Phil-dav/OpenAstroTracker/OpenAstroTracker/Pieces STL/images/Veil_500mm_dunkler.jpg

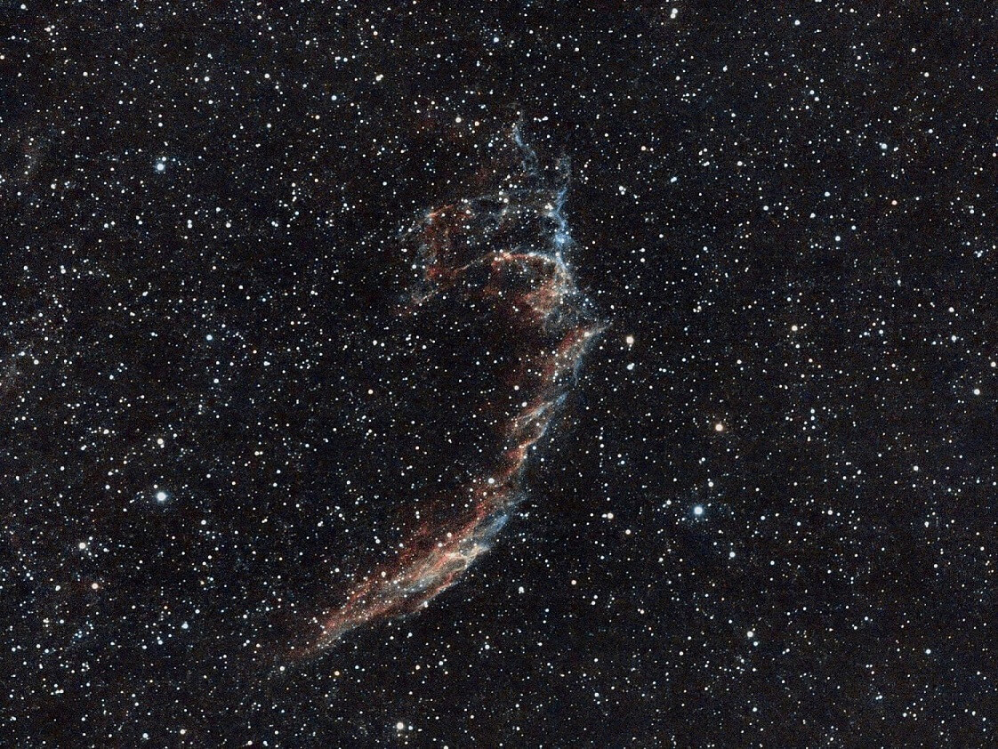
OpenAstroTracker/Pieces STL/images/Veil_500mm_dunkler.jpg
