Phil-dav/OpenAstroTracker/OpenAstroTracker/Pieces STL/images/11_DEC_motor_mount_v6.png

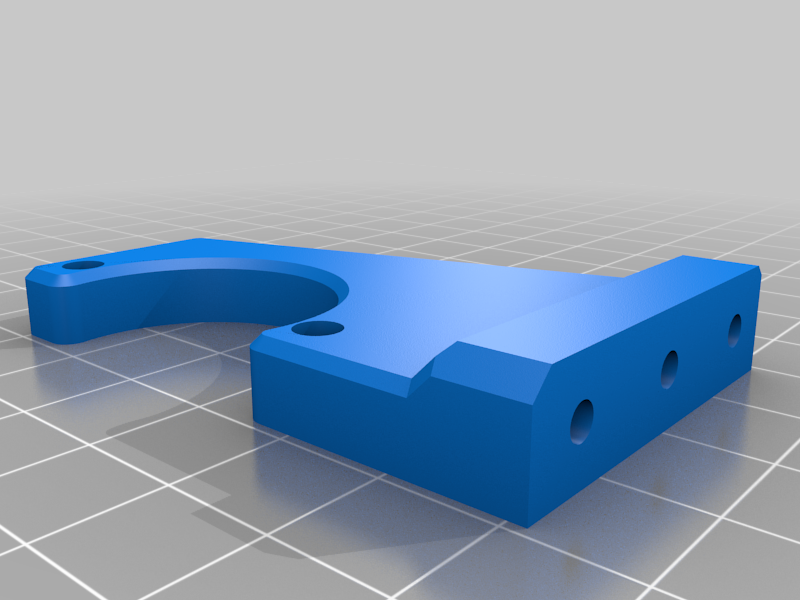
OpenAstroTracker/Pieces STL/images/11_DEC_motor_mount_v6.png
