Phil-dav/OpenAstroTracker/OpenAstroTracker/Pieces STL/README.txt

OpenAstroTracker - DSLR tracking & GoTo mount by openastrotech on Thingiverse: https://www.thingiverse.com/thing:4167783
