Phil-dav/OpenAstroTracker/OpenAstroTracker/Pieces STL/images/05.1_pole_v4.png

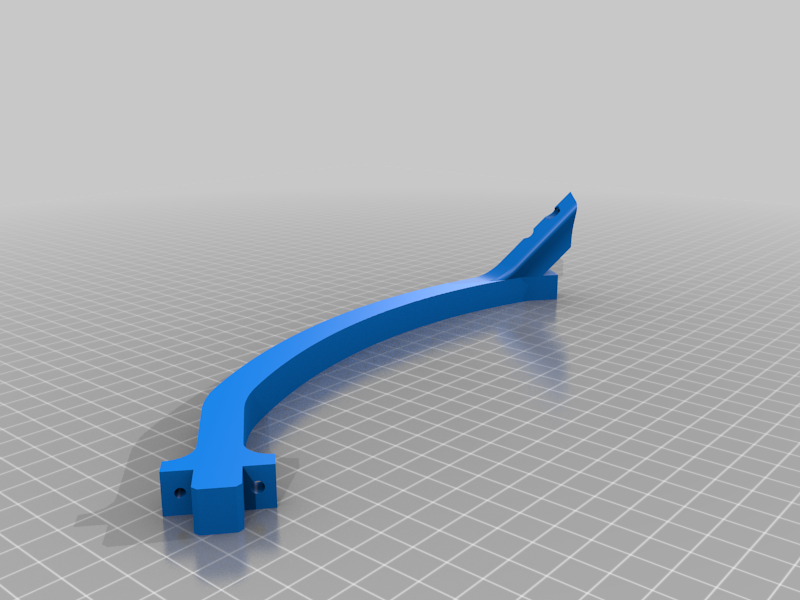
OpenAstroTracker/Pieces STL/images/05.1_pole_v4.png
