Phil-dav/OpenAstroTracker/OpenAstroTracker/Pieces STL/images/05_pole_v5.png

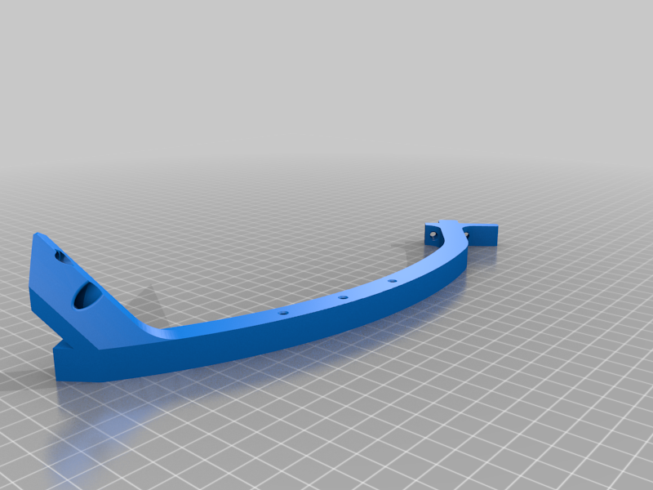
OpenAstroTracker/Pieces STL/images/05_pole_v5.png
