Phil-dav/OpenAstroTracker/OpenAstroTracker/Pieces STL/images/06a_splitring_part1_timingbelt.png

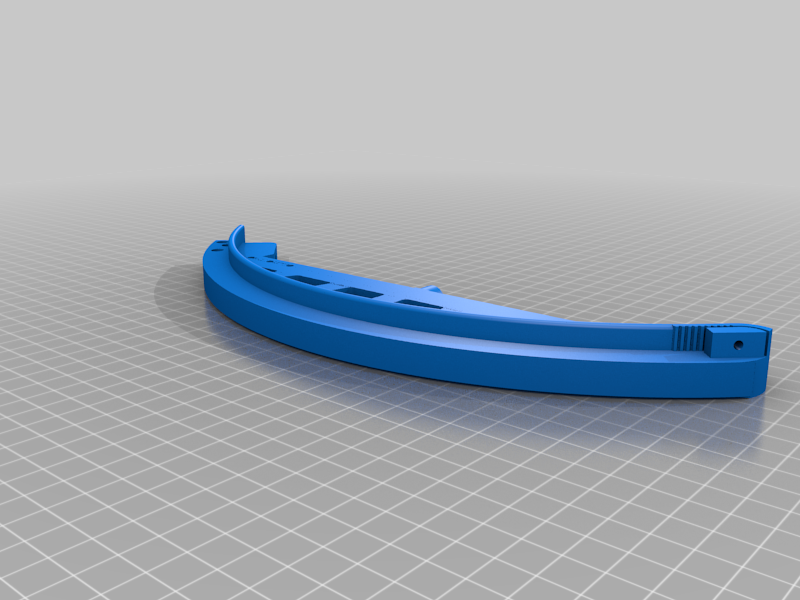
OpenAstroTracker/Pieces STL/images/06a_splitring_part1_timingbelt.png
