Phil-dav/OpenAstroTracker/OpenAstroTracker/Pieces STL/images/06b_splitring_part2_timingbelt.png

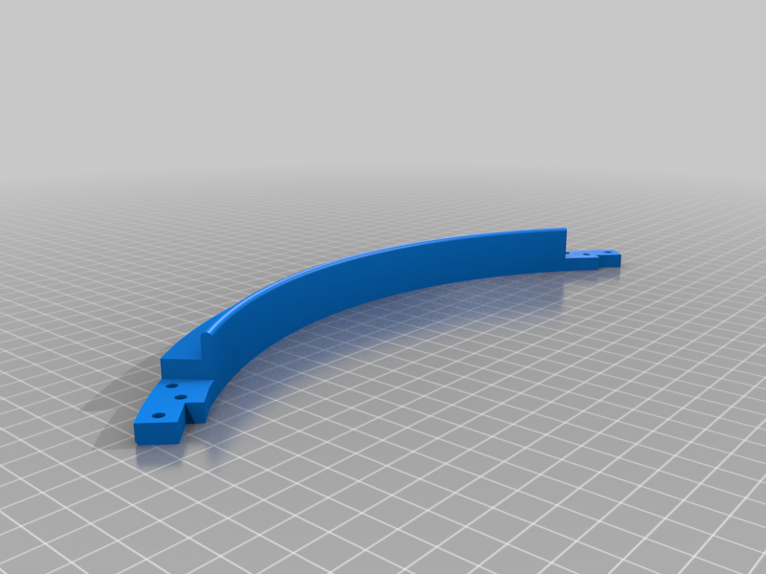
OpenAstroTracker/Pieces STL/images/06b_splitring_part2_timingbelt.png
