Phil-dav/OpenAstroTracker/OpenAstroTracker/Pieces STL/images/06b_splitring_part2_v4.png

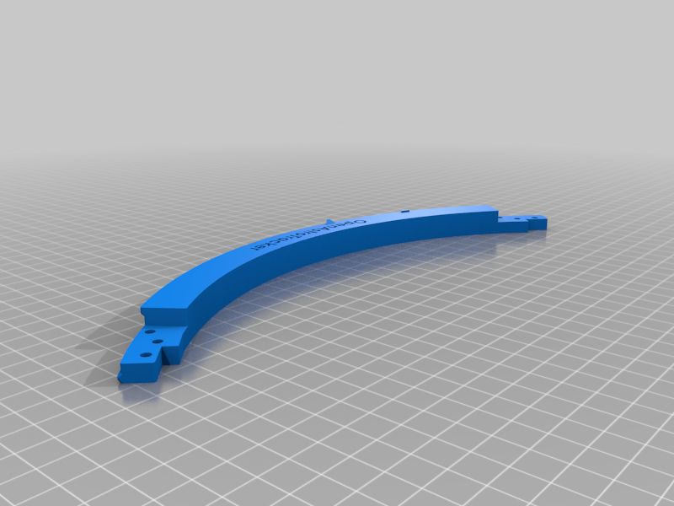
OpenAstroTracker/Pieces STL/images/06b_splitring_part2_v4.png
