Phil-dav/OpenAstroTracker/OpenAstroTracker/Pieces STL/images/06c_splitring_part3_v4.png

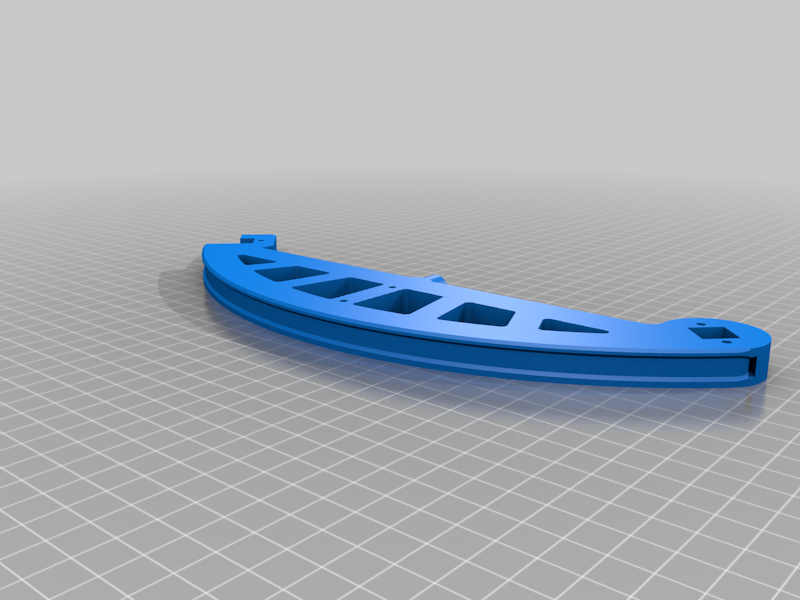
OpenAstroTracker/Pieces STL/images/06c_splitring_part3_v4.png
