Phil-dav/OpenAstroTracker/OpenAstroTracker/Pieces STL/images/11_DEC_motor_mount_v8_low.png

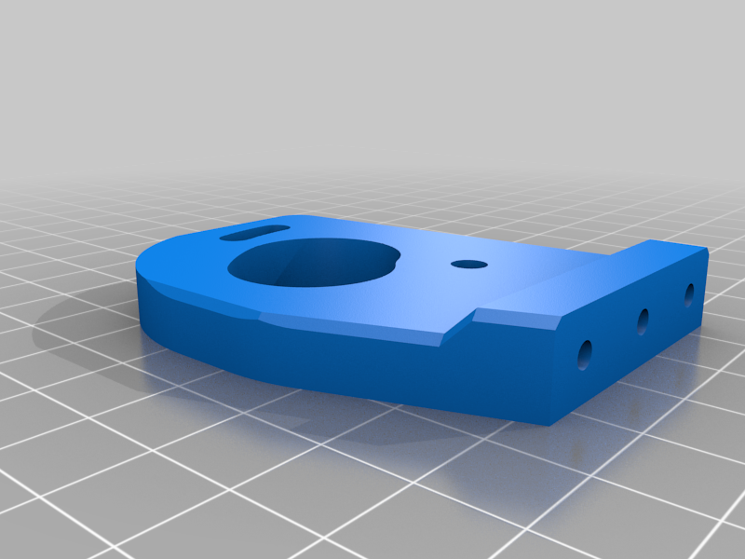
OpenAstroTracker/Pieces STL/images/11_DEC_motor_mount_v8_low.png
