Phil-dav/OpenAstroTracker/OpenAstroTracker/Pieces STL/images/14_RAmotor_mount_low_v4.png

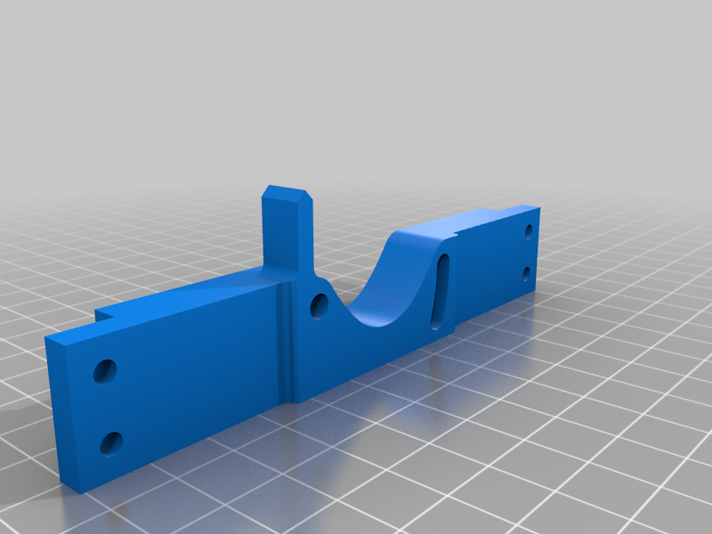
OpenAstroTracker/Pieces STL/images/14_RAmotor_mount_low_v4.png
