Phil-dav/OpenAstroTracker/OpenAstroTracker/Pieces STL/images/14_RAmotor_mount_NEMA_down_v4.png

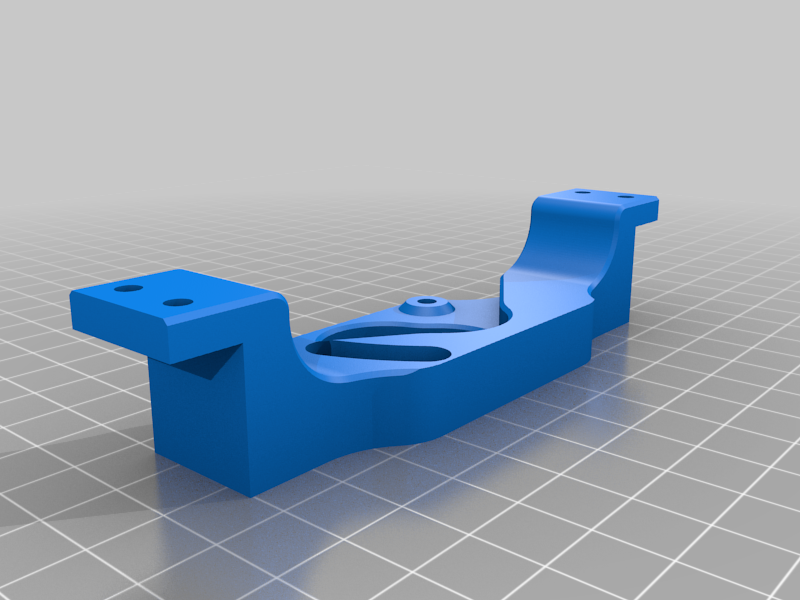
OpenAstroTracker/Pieces STL/images/14_RAmotor_mount_NEMA_down_v4.png
