Phil-dav/OpenAstroTracker/OpenAstroTracker/Pieces STL/images/Cygnus_Wall.jpg

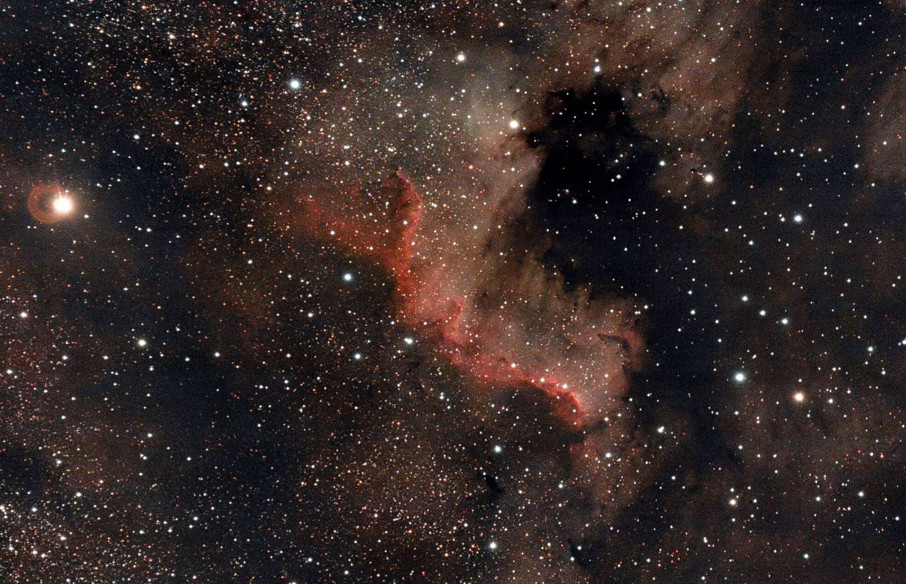
OpenAstroTracker/Pieces STL/images/Cygnus_Wall.jpg
