Phil-dav/OpenAstroTracker/OpenAstroTracker/Pieces STL/images/DSC02870_-_1.JPG

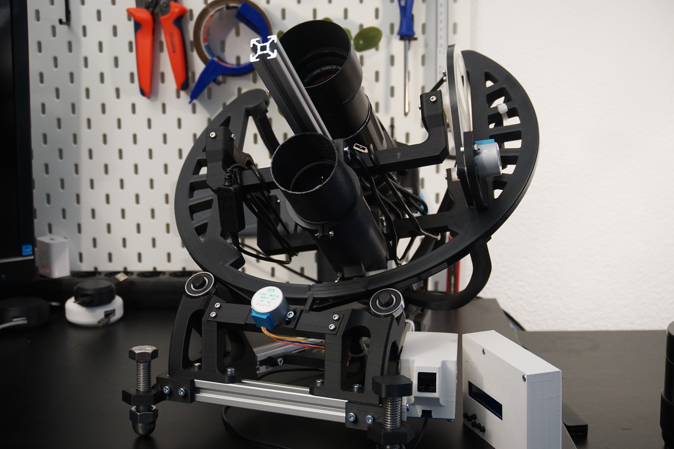
OpenAstroTracker/Pieces STL/images/DSC02870_-_1.JPG
