Phil-dav/OpenAstroTracker/OpenAstroTracker/Pieces STL/images/Rosette_200mm.jpg

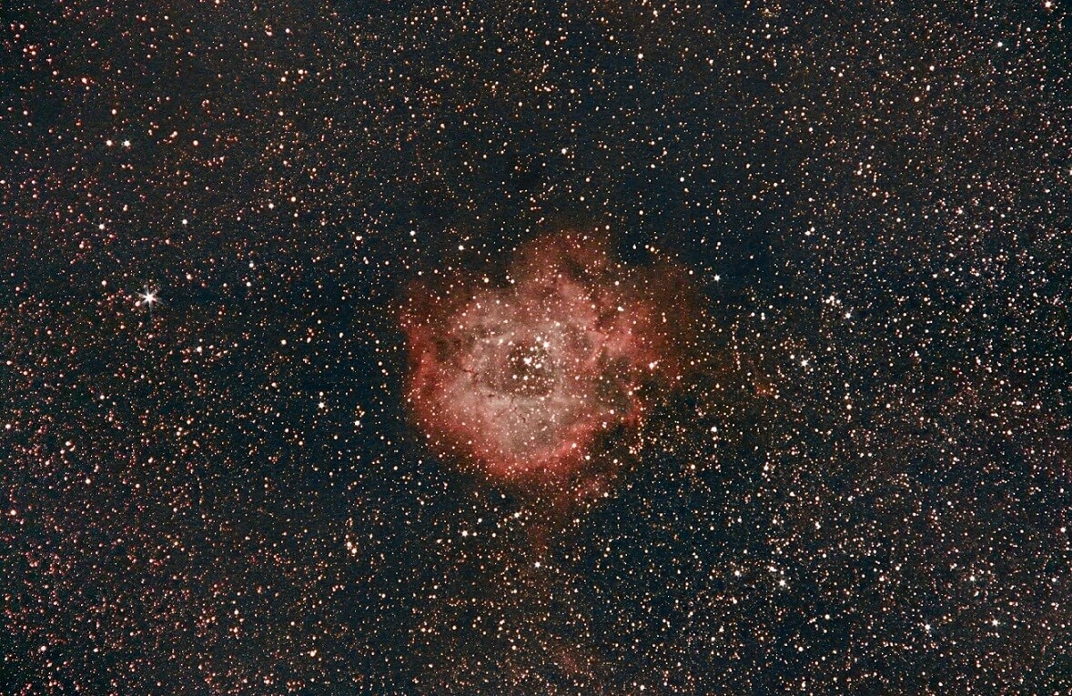
OpenAstroTracker/Pieces STL/images/Rosette_200mm.jpg
