Phil-dav/OpenAstroTracker/OpenAstroTracker/Pieces STL/images/Sadr_mosaic.jpg

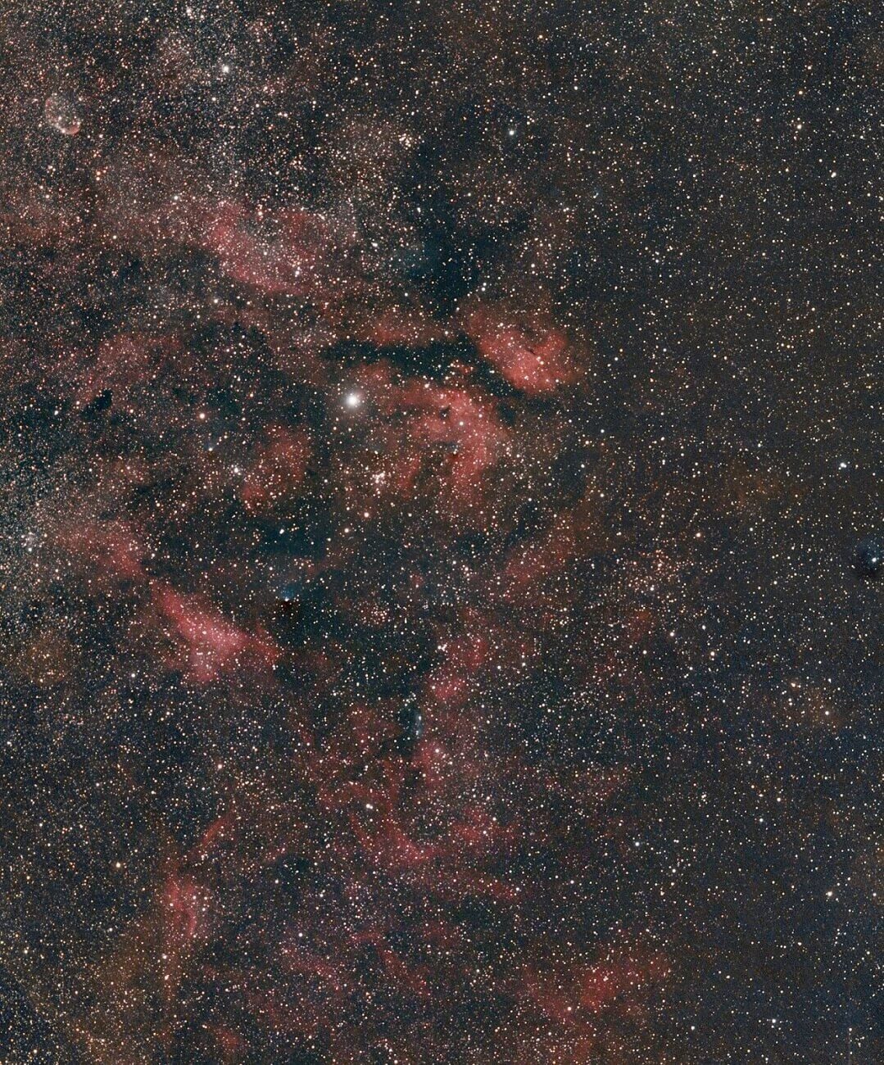
OpenAstroTracker/Pieces STL/images/Sadr_mosaic.jpg
