Phil-dav/OpenAstroTracker/OpenAstroTracker/Pieces STL/images/Veil_Nebula.jpg

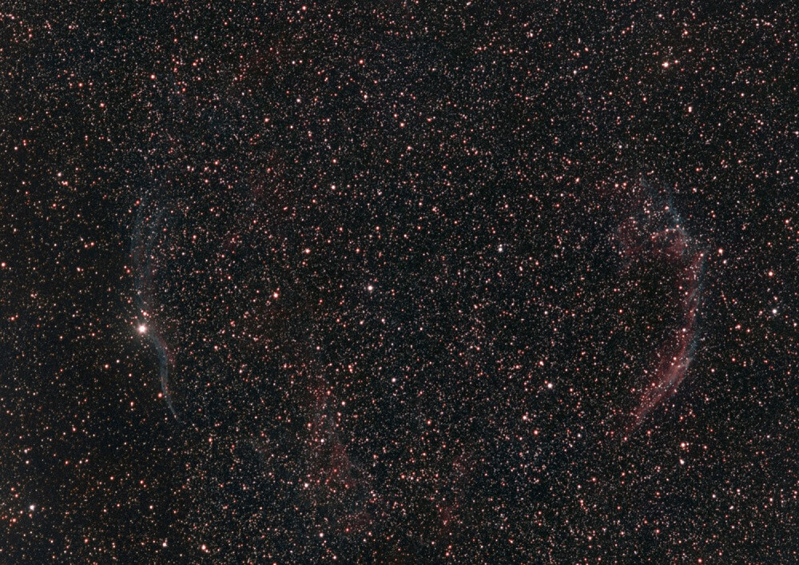
OpenAstroTracker/Pieces STL/images/Veil_Nebula.jpg
