Phil-dav/OpenAstroTracker/OpenAstroTracker/OpenAstroTracker.ods

Sheet: Matériel
Site web vidéo (https://www.youtube.com/watch?v=-_auhM7WlDY&t=2187s)
Matériel ma liste achat
Contrôleur | Arduino MEGA | Aliexpress (https://fr.aliexpress.com/item/32850843888.html?mp=1)
Driver moteur | TMC2209 V4 | Aliexpress (https://fr.aliexpress.com/item/1005004604384978.html?mp=1) | Github (https://github.com/janelia-arduino/TMC2209)
Bouclier Arduino mega | RAMPS 1.4 | Aliexpress (https://fr.aliexpress.com/item/4001009988191.html?mp=1)
Moteur pas à pas | JK42HM34-1334 | Aliexpress (https://fr.aliexpress.com/item/1005001780042317.html?curPageLogUid=1Xe0u0MpPdUn)
Alimentation | 12V 5A
site OpenAstro Tracker (https://wiki.openastrotech.com/OpenAstroTracker/ShoppingList)
Type | Taille | Qté | Lien | PU | P.TOT
Liste pièces mécanique
Vis | M3 x 12mm | 60 |  |  | 0,00 €
Vis | M4 x 12mm | 40 |  |  | 0,00 €
Écrous | M3 | 10 |  |  | 0,00 €
Écrous | M4 x 12mm | 4 |  |  | 0,00 €
Écrous en T | M4 (qté 32) | 1 | Aliexpress (https://s.click.aliexpress.com/e/_AefrLD) | 4,40 € | 4,40 €
Inserts chauffants | M3 x 4,6 x 6 (qté 60) | 1 | Aliexpress (https://s.click.aliexpress.com/e/_AkxV9W) | 7,04 € | 7,04 €
Roulements à billes | 6001ZZ 2RS 12x28x8 mm | 4 | Aliexpress (https://s.click.aliexpress.com/e/_AtjH6R) | 1,24 € | 4,96 €
Roulements à billes | 6801 2RS 12x21x5 mm | 1 | Aliexpress (https://s.click.aliexpress.com/e/_9HGluj) | 1,20 € | 1,20 €
Courroie | GT2 6mm, Pas : 2mm | 1 | Aliexpress (https://s.click.aliexpress.com/e/_9fPOpt) | 6,06 € | 6,06 €
Poulie | GT2, d=5mm, 16T | 2 | Aliexpress (https://s.click.aliexpress.com/e/_APxEH1) | 1,98 € | 3,95 €
Extrusion d’aluminium 2020 argent | Fentes 300 mm, 20x20, 6mm | 3 | Aliexpress (https://s.click.aliexpress.com/e/_9HfYqF) | 5,45 € | 16,35 €
Extrusion d’aluminium 2020 argent | Fentes 200 mm, 20x20, 6mm | 1 | Aliexpress (https://s.click.aliexpress.com/e/_9HfYqF) | 4,11 € | 4,11 €
plaque à dégagement | QR-120S | 1 | Aliexpress (https://s.click.aliexpress.com/e/_AM3KRV) | 16,65 € | 16,65 €
 |  |  |  | S/Total | 64,72 €
Liste pièces électronique |  |  |  |  | 0,00 €
Driver moteur | TMC2209 V3 UART | 2 | Aliexpress (https://s.click.aliexpress.com/e/_A9hcPV) | 6,06 € | 12,12 €
Bouclier Arduino mega | RAMPS 1.4 | 1 | Aliexpress (https://fr.aliexpress.com/item/32964178488.html?gatewayAdapt=glo2fra) | 3,56 € | 3,56 €
Moteur pas à pas | 42HS34 | 2 | Aliexpress (https://fr.aliexpress.com/item/1005005281739306.html?mp=1) | 2,45 € | 4,90 €
Microcontrôleur | Arduino MEGA | 1 | Aliexpress (https://fr.aliexpress.com/item/32837987554.html?gatewayAdapt=glo2fra) | 11,04 € | 11,04 €
Alimentation | 12V 5A | 0 | Aliexpress (https://de.aliexpress.com/item/4000594896227.html?curPageLogUid=b2LSTh6E30wo) | 10,08 € | 0,00 €
Niveau à bulle | MPU6050 | 0 | Aliexpress (https://fr.aliexpress.com/item/1005001423725674.html?curPageLogUid=iWajDq34SGA2) | 2,71 € | 0,00 €
Écran | Schild LCD1602 | 0 | Aliexpress (https://de.aliexpress.com/item/32346775046.html) | 3,09 € | 0,00 €
GPS | GY-NEO6MV2 | 0 | Aliexpress (https://fr.aliexpress.com/item/1005001635722164.html?gatewayAdapt=glo2fra) | 2,59 € | 0,00 €
Prise CC | prise CC femelle et mâle | 1 | Aliexpress (https://fr.aliexpress.com/item/1005002476509656.html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) | 0,17 € | 0,17 €
 |  |  |  | S/Total | 31,79 €
Liste PLA
Bobine PLA | Noire | 1 | Aliexpress (https://fr.aliexpress.com/item/1005005828733628.html?mp=1) | 21,37 € | 21,37 €
Bobine PLA | Bleu | 1 | Aliexpress (https://fr.aliexpress.com/item/1005005828733628.html?mp=1) | 22,21 € | 22,21 €
 |  |  |  | S/Total | 43,58 €
 |  |  |  | port env | 8,00 €
 |  |  |  | Total | 148,09 €
Manque niveau à bulle

Sheet: Impression 3D
 | 00_calibration.stl (https://wiki.openastrotech.com/Knowledge/Printing)
 | Mesure plan | Mesure Réelle
 | 12 | 11,95
 | 50 | 49,94
 | 50 | 49,82
 |  |  |  |  |  |  |  |  | 22
 | Assemblage OpenAstro Tracker (https://wiki.openastrotech.com/en/OpenAstroTracker/Assembly#Assemblage%20OpenAstro%20Tracker)
 | Pièces SLT |  |  |  |  |  |  |  |  |  |  | 26 Adaptater
 | Liste pièces Github (https://github.com/OpenAstroTech/OpenAstroTracker/tree/master/STL)
 | Liste pièces Google docs (https://docs.google.com/spreadsheets/d/1aTgntsu-4ORosllMIWCY5KyekX660bD8m7at5K0p5JA/edit#gid=0)
 | L'assemblage kit (https://wiki.openastrotech.com/OpenAstroTracker/Kit-Assembly)
 |  |  |  |  |  |  | 23 | 24
 |  | 25 |  | 13 |  |  |  |  |  | 11 |  |  | 15 |  | 7
 |  |  | 12
 |  |  |  |  |  |  |  |  |  |  |  | 18 -19
 | Non utilisé |  | 1 | 2 |  | 3 |  | 4
 |  |  |  |  |  |  |  |  |  | 8 |  |  | 10 |  | 5 | 6
 |  |  | 21
 |  |  |  |  |  |  |  |  |  |  |  |  | 16 -17
 |  |  |  |  | 20
 |  |  |  |  |  |  |  | 14
 |  |  |  |  |  |  |  |  |  |  |  | 9
 |  |  |  |  |  |  |  |  |  |  |  | Base
 |  |  |  |  |  |  |  |  |  |  |  | Anneau
N° | Désignation |  | Pages Github |  |  |  |  |  |  | Dossier | Qté | Ordre montage | Nom fr | Temps IMP | Support
26 | b3_2020adapter |  | https://github.com/OpenAstroTech/OpenAstroTracker/blob/master/STL/2020 Base/b3_2020 adapter.STL |  |  |  |  |  |  | de 2020base | 1 | 1 | Adaptateur | 00:50
23 | b1_connector_left |  | https://github.com/OpenAstroTech/OpenAstroTracker/blob/master/STL/2020 Base/b1_connector_left.STL |  |  |  |  |  |  | de 2020base | 1 | 2,1 | Connecteur de base | 02:00 | oui
24 | b1_connector_right |  | https://github.com/OpenAstroTech/OpenAstroTracker/blob/master/STL/2020 Base/b1_connector_right.STL |  |  |  |  |  |  | de 2020base | 1 | 2,2 | Connecteur de base
12 | M14_mount_left_2020base |  | https://github.com/OpenAstroTech/OpenAstroTracker/blob/master/STL/2020 Base/M14_mount_left_2020base.STL |  |  |  |  |  |  | de 2020base | 1 | 3,1 | montage frontal
13 | M14_mount_right_2020base |  | https://github.com/OpenAstroTech/OpenAstroTracker/blob/master/STL/2020 Base/M14_mount_right_2020base.STL |  |  |  |  |  |  | de 2020base | 1 | 3,2 | montage frontal
25 | b2_level_holder |  | https://github.com/OpenAstroTech/OpenAstroTracker/blob/master/STL/2020 Base/b2_level holder_31mm.STL |  |  |  |  |  |  | de 2020base | 1 | 4 | Porte niveau
3 | 04_rollmount_left_40°_v6_2020base_TI |  | https://github.com/OpenAstroTech/OpenAstroTracker/blob/master/STL/40deg/04_rollmount left_40°_v6_2020base_TI.STL |  |  |  |  |  |  | de 2020base | 1 | 5,1 | Support rouleau | 07:20 | oui
4 | 04_rollmount_right_40°_v6_2020base_TI |  | https://github.com/OpenAstroTech/OpenAstroTracker/blob/master/STL/40deg/04_rollmount right_40°_v6_2020base_TI.STL |  |  |  |  |  |  | de 2020base | 1 | 5,2 | Support rouleau | 07:20 | oui
1 | 02_angle_40deg_v2_2020base |  | https://github.com/OpenAstroTech/OpenAstroTracker/blob/master/STL/40deg/02_angle_40deg_v2_2020base.STL |  |  |  |  |  |  | de 2020base | 1 | 6 | Angle arrière | 03:30
14 | M14_mount_rear_2020base_v2 |  | https://github.com/OpenAstroTech/OpenAstroTracker/blob/master/STL/2020 Base/M14_mount_rear_2020base_v2.STL |  |  |  |  |  |  | de 2020base | 1 | 7 | Support arrière
15 | 14_RAmotor_mount_NEMA_down_v4 |  | https://github.com/OpenAstroTech/OpenAstroTracker/blob/master/STL/All latitudes/14_RAmotor_mount_NEMA_down_v4.STL |  |  |  |  |  |  |  | 1 | 8 | Support moteur RA
11 | 11_DEC_motor_mount_v9_NEMA_TI |  | https://github.com/OpenAstroTech/OpenAstroTracker/blob/master/STL/All latitudes/11_DEC_motor_mount_v9_NEMA_TI.STL |  |  |  |  |  |  |  | 1 | A1 | Support moteur DEC
8 | 06a_splitring_part1_v4_TI |  | https://github.com/OpenAstroTech/OpenAstroTracker/blob/master/STL/All latitudes/06a_splitring_part1_v4_TI.STL |  |  |  |  |  |  |  | 1 | A2 | Anneau RA support moteur DEC | 02:00
9 | 06b_splitring_part2_v4_TI |  | https://github.com/OpenAstroTech/OpenAstroTracker/blob/master/STL/All latitudes/06b_splitring_part2_v4_TI.STL |  |  |  |  |  |  |  | 1 | A2,1 | Anneau centre
20 | u2_bearing_holder_TI |  | https://github.com/OpenAstroTech/OpenAstroTracker/blob/master/STL/Universal mount/u2_bearing_holder_TI.STL |  |  |  |  |  |  | de Universal_mount | 1 | A3,1 | Support roulement DEC
18 | u1_Lholder_right_back |  | https://github.com/OpenAstroTech/OpenAstroTracker/blob/master/STL/Universal mount/u1_Lholder_right_back.STL |  |  |  |  |  |  | de Universal_mount | 1 | A3,2 | Support roulement DEC
19 | u1_Lholder_right_front |  | https://github.com/OpenAstroTech/OpenAstroTracker/blob/master/STL/Universal mount/u1_Lholder_right_front.STL |  |  |  |  |  |  | de Universal_mount | 1 | A3,3 | Support roulement DEC
10 | 06c_splitring_part3_v4_TI |  | https://github.com/OpenAstroTech/OpenAstroTracker/blob/master/STL/All latitudes/06c_splitring_part3_v4_TI.STL |  |  |  |  |  |  |  | 1 | A3,4 | Anneau RA support roue
21 | u3_drivedisc_DEC_unimount_v3_TI |  | https://github.com/OpenAstroTech/OpenAstroTracker/blob/master/STL/Universal mount/u3_drivedisc_DEC_unimount_v3_TI.STL |  |  |  |  |  |  |  | 1 | A4,1 | Roue DEC | 09:00
16 | u1_Lholder_left_back |  | https://github.com/OpenAstroTech/OpenAstroTracker/blob/master/STL/Universal mount/u1_Lholder_left_back.STL |  |  |  |  |  |  | de Universal_mount | 1 | A4,2 | Support roue
17 | u1_Lholder_left_front |  | https://github.com/OpenAstroTech/OpenAstroTracker/blob/master/STL/Universal mount/u1_Lholder_left_front.STL |  |  |  |  |  |  | de Universal_mount | 1 | A4,3 | Support roue
2 | 03_polemount_6801_v3_TI |  | https://github.com/OpenAstroTech/OpenAstroTracker/blob/master/STL/All latitudes/03_polemount_6801_v3_TI.STL |  |  |  |  |  |  |  | 1 | A5,1 | Montage sur poteau | 01:30 | oui
5 | 05_pole_v5_TI |  | https://github.com/OpenAstroTech/OpenAstroTracker/blob/master/STL/All latitudes/05_pole_v5_TI.STL |  |  |  |  |  |  |  | 2 | A5,2 | Poteau supérieur | 04:10 | oui
6 | 05.1_pole_v4_TI |  | https://github.com/OpenAstroTech/OpenAstroTracker/blob/master/STL/All latitudes/05.1_pole_v4_TI.STL |  |  |  |  |  |  |  | 2 | A5,3 | Poteau inférieur | 03:50 | oui
7 | 05.2_stabilizer |  | https://github.com/OpenAstroTech/OpenAstroTracker/blob/master/STL/All latitudes/05.2_stabilizer.STL |  |  |  |  |  |  |  | 1 | A5,4 | Stabilisateur | 03:50 | oui
22 | u4_holder |  | https://github.com/OpenAstroTech/OpenAstroTracker/blob/master/STL/Universal mount/u4_holder.STL |  |  |  |  |  |  |  | 2 | A6 | Porteur support camera
 |  |  |  |  |  |  |  |  |  | Total | 29 |  |  | 21:20
 |  |  |  |  |  |  |  |  |  |  |  |  |  | Ender 3 PRO réglage général
 | Attention imp 200X200 |  |  |  |  |  |  |  |  |  |  |  |  | Parois | 3
8 | 06a_splitring_part1_v4_200x200 For_200x200_printers |  |  |  |  |  |  |  |  |  |  |  |  | Couches sup/inf | 4
10 | 06c_splitring_part3_v4_200x200 For_200x200_printers |  |  |  |  |  |  |  |  |  |  |  |  | Remplissage | 20,00 %
 |  |  |  |  |  |  |  |  |  |  |  |  |  | Hauteur de couche | 0,2 | mm
 |  |  |  |  |  |  |  |  |  |  |  |  |  | Buse
 |  |  |  |  |  |  |  |  |  |  |  |  |  | Vitesse | 50 | mm/s
