Phil-dav/OpenAstroTracker/OpenAstroTracker/Pieces STL/06a_splitring_part1_v4f_200x200.STL

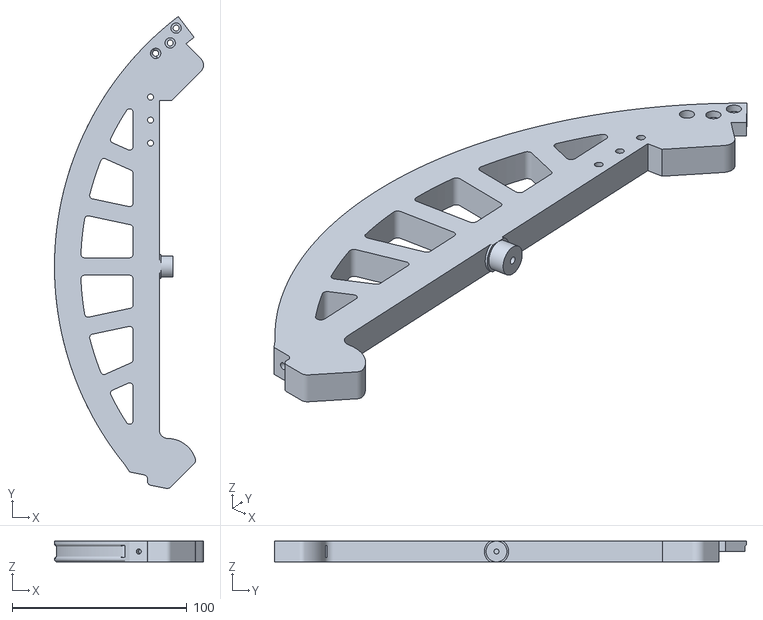
[picture p35: CAD file, 2023-11-13]
OpenAstroTracker/Pieces STL/06a_splitring_part1_v4f_200x200.STL
85.4 x 270.3 x 12.0
