Phil-dav/OpenAstroTracker/OpenAstroTracker/Pieces STL/files/16_NEMA_electronicsbox_lid.STL

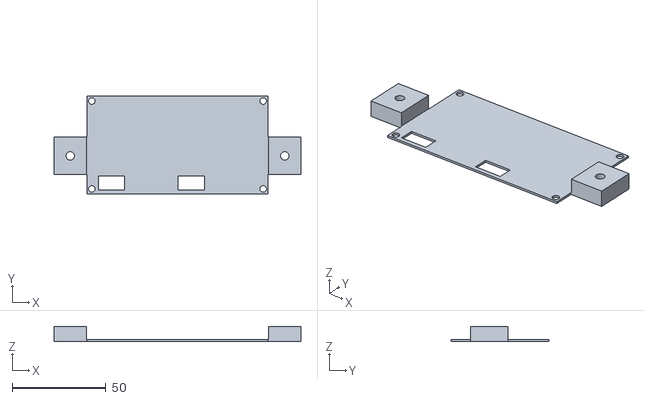
[picture p36: CAD file, 2023-11-13]
OpenAstroTracker/Pieces STL/files/16_NEMA_electronicsbox_lid.STL
132.1 x 52.4 x 8.00
