Phil-dav/OpenAstroTracker/OpenAstroTracker/Pieces STL/files/20deg/04_rollmount left_20°_v5_2020base.STL

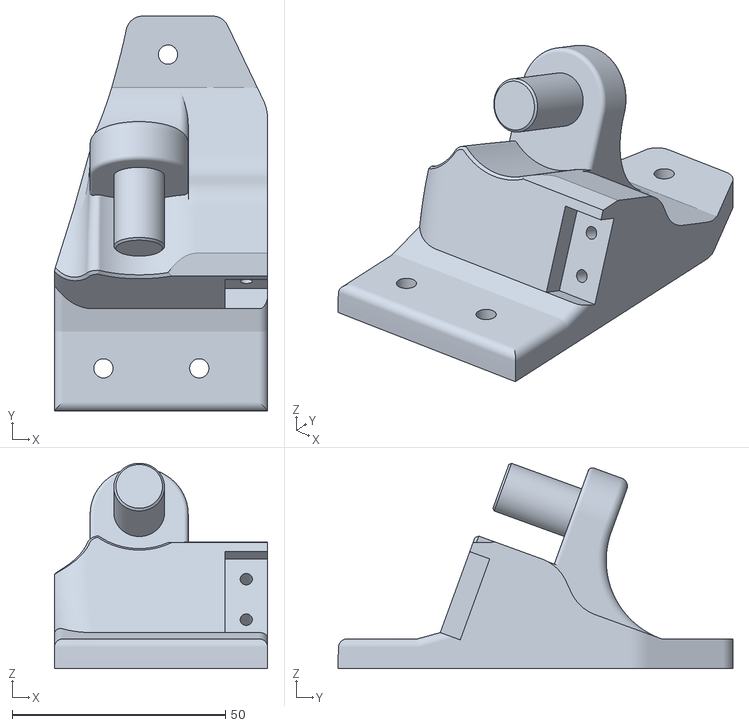
[picture p37: CAD file, 2023-11-13]
OpenAstroTracker/Pieces STL/files/20deg/04_rollmount left_20°_v5_2020base.STL
50.0 x 92.6 x 48.2
