Phil-dav/OpenAstroTracker/OpenAstroTracker/Pieces STL/files/30deg/04_rollmount right_30°_v6_2020base.STL

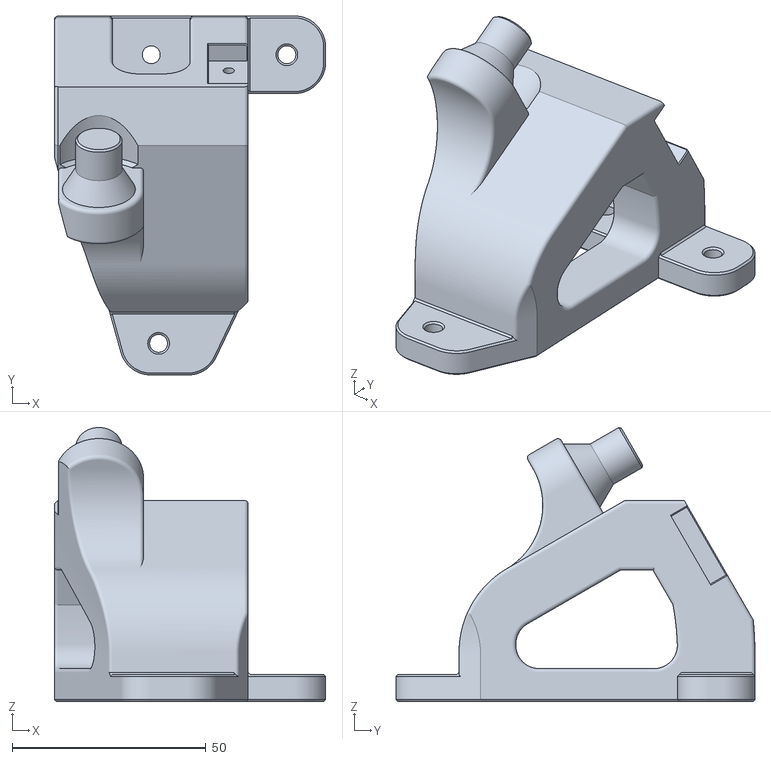
[picture p38: CAD file, 2023-11-13]
OpenAstroTracker/Pieces STL/files/30deg/04_rollmount right_30°_v6_2020base.STL
70.0 x 92.6 x 70.7
