Phil-dav/OpenAstroTracker/OpenAstroTracker/Pieces STL/files/40deg/04_rollmount left_40°_v6_2020base.STL

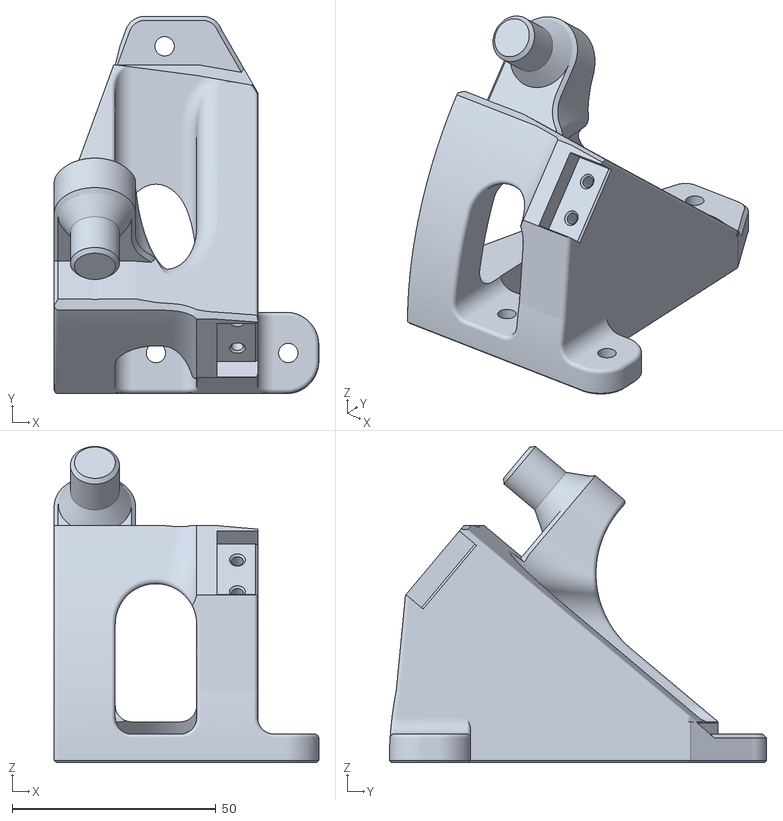
[picture p39: CAD file, 2023-11-13]
OpenAstroTracker/Pieces STL/files/40deg/04_rollmount left_40°_v6_2020base.STL
65.0 x 92.7 x 77.6
