Phil-dav/OpenAstroTracker/OpenAstroTracker/Pieces STL/files/50deg/02_angle_50deg_v4_2020base.STL

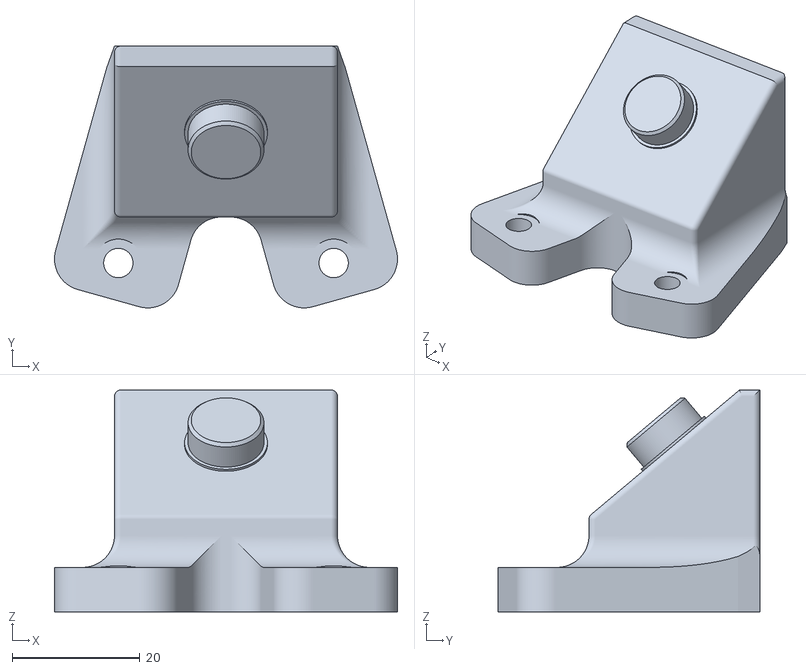
[picture p40: CAD file, 2023-11-13]
OpenAstroTracker/Pieces STL/files/50deg/02_angle_50deg_v4_2020base.STL
53.8 x 41.1 x 34.8
