Phil-dav/OpenAstroTracker/OpenAstroTracker/Pieces STL/Pièces réalisées/00_calibration.STL

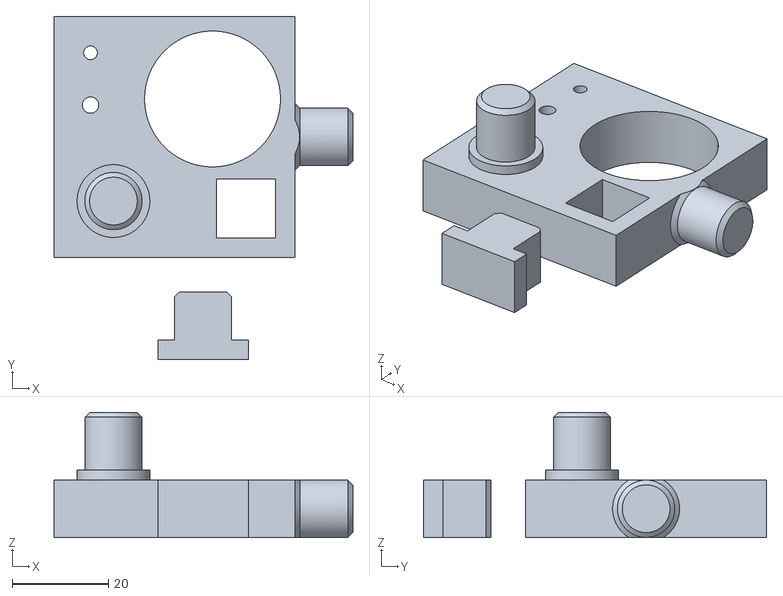
[picture p41: CAD file, 2023-11-13]
OpenAstroTracker/Pieces STL/Pièces réalisées/00_calibration.STL
62.0 x 71.2 x 26.0
