Phil-dav/OpenAstroTracker/OpenAstroTracker/Pieces STL/Pièces à réalisées/M14_mount_rear_2020base_v2.STL

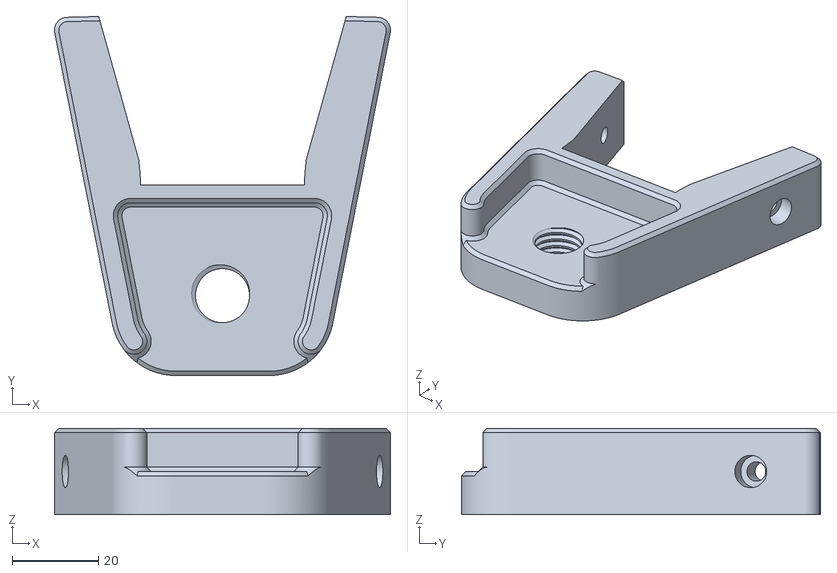
[picture p42: CAD file, 2023-11-13]
OpenAstroTracker/Pieces STL/Pièces à réalisées/M14_mount_rear_2020base_v2.STL
77.8 x 83.2 x 20.0
