Phil-dav/OpenAstroTracker/OpenAstroTracker/Pieces STL/files/06b_splitring_part2_v4.STL

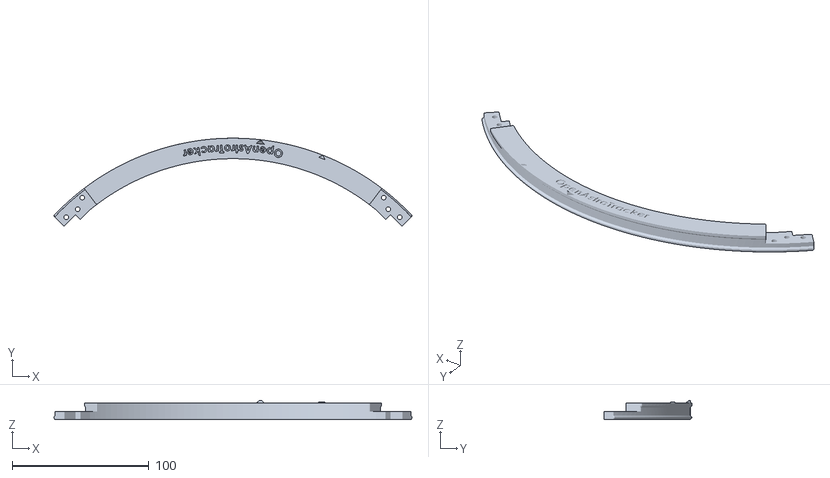
[picture p44: CAD file, 2023-11-13]
OpenAstroTracker/Pieces STL/files/06b_splitring_part2_v4.STL
262.1 x 64.2 x 14.0
