Phil-dav/OpenAstroTracker/OpenAstroTracker/Pieces STL/files/20deg/02_angle_20deg_2020base.STL

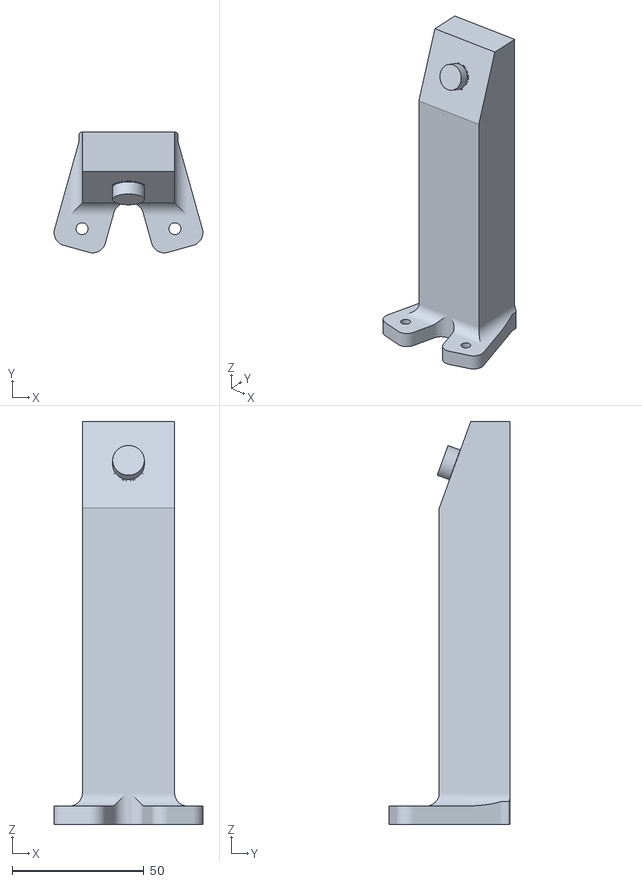
[picture p45: CAD file, 2023-11-13]
OpenAstroTracker/Pieces STL/files/20deg/02_angle_20deg_2020base.STL
56.5 x 45.8 x 152.9
