Phil-dav/OpenAstroTracker/OpenAstroTracker/Pieces STL/Pièces à réalisées/05_pole_v5_TI.STL

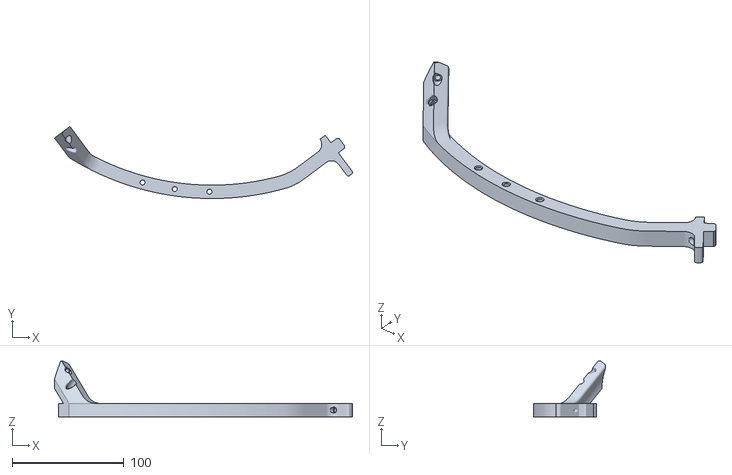
[picture p46: CAD file, 2023-11-13]
OpenAstroTracker/Pieces STL/Pièces à réalisées/05_pole_v5_TI.STL
266.7 x 64.5 x 49.7
