Phil-dav/OpenAstroTracker/OpenAstroTracker/Pieces STL/files/30deg/02_angle_30deg_2020base_v2.STL

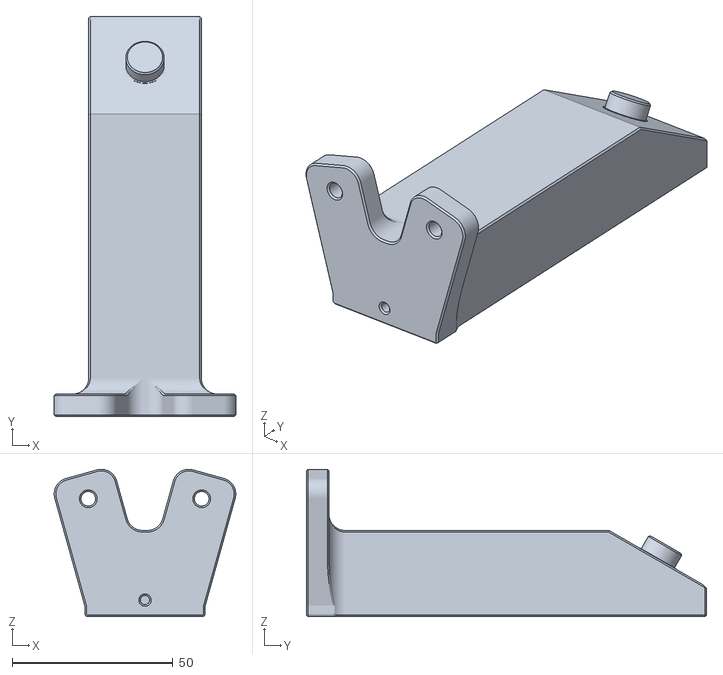
[picture p47: CAD file, 2023-11-13]
OpenAstroTracker/Pieces STL/files/30deg/02_angle_30deg_2020base_v2.STL
56.5 x 124.3 x 45.8
