Phil-dav/OpenAstroTracker/OpenAstroTracker/Pieces STL/files/c1_bottom.STL

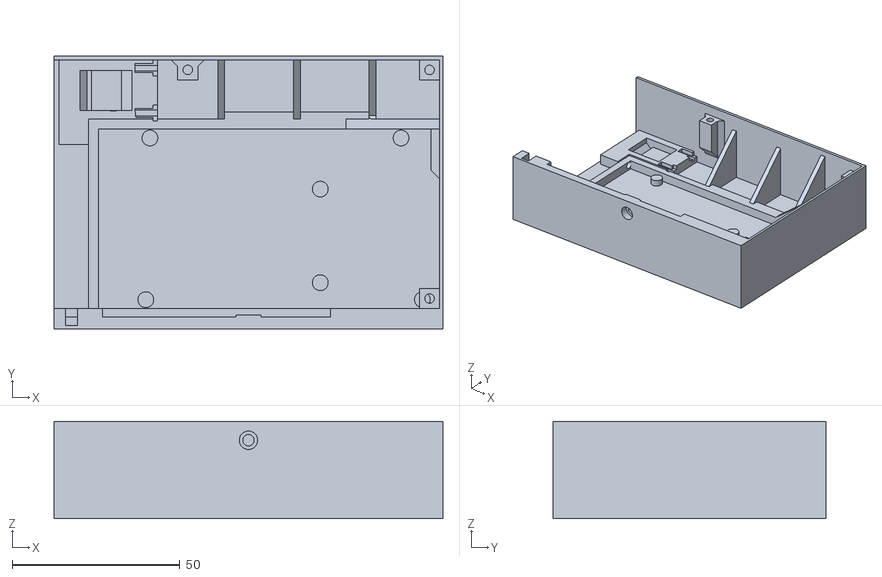
[picture p48: CAD file, 2023-11-13]
OpenAstroTracker/Pieces STL/files/c1_bottom.STL
116.0 x 81.4 x 29.0
