Phil-dav/OpenAstroTracker/OpenAstroTracker/Pieces STL/Pièces à réalisées/11_DEC_motor_mount_v9_NEMA_TI.STL

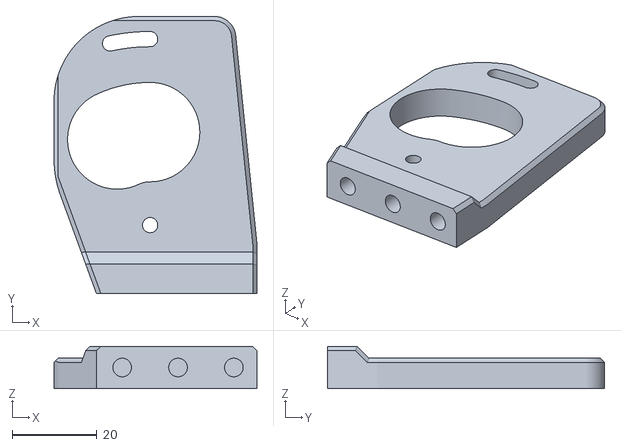
[picture p49: CAD file, 2023-11-13]
OpenAstroTracker/Pieces STL/Pièces à réalisées/11_DEC_motor_mount_v9_NEMA_TI.STL
47.9 x 65.4 x 10.0
