Phil-dav/OpenAstroTracker/OpenAstroTracker/Pieces STL/files/b2_level holder.STL

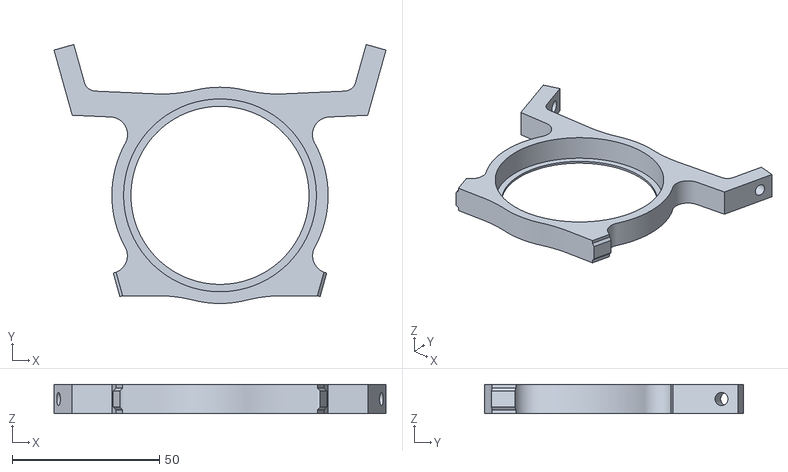
[picture p50: CAD file, 2023-11-13]
OpenAstroTracker/Pieces STL/files/b2_level holder.STL
112.8 x 88.0 x 10.00
