Phil-dav/OpenAstroTracker/OpenAstroTracker/Pieces STL/Pièces à réalisées/02_angle_40deg_v2_2020base.STL

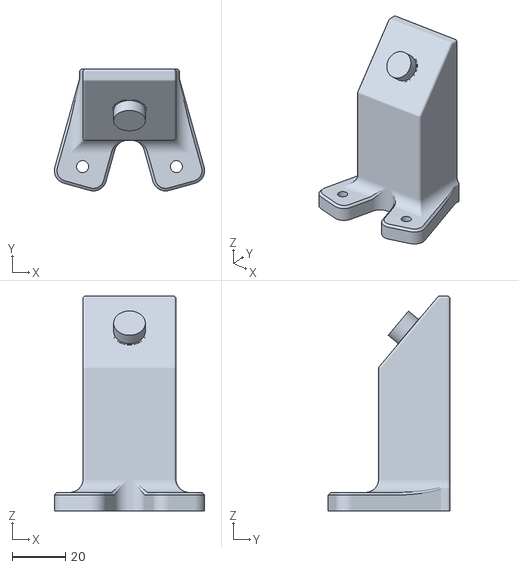
[picture p51: CAD file, 2023-11-13]
OpenAstroTracker/Pieces STL/Pièces à réalisées/02_angle_40deg_v2_2020base.STL
56.5 x 45.8 x 80.8
