Phil-dav/OpenAstroTracker/OpenAstroTracker/Pieces STL/files/b1_connector_right.STL

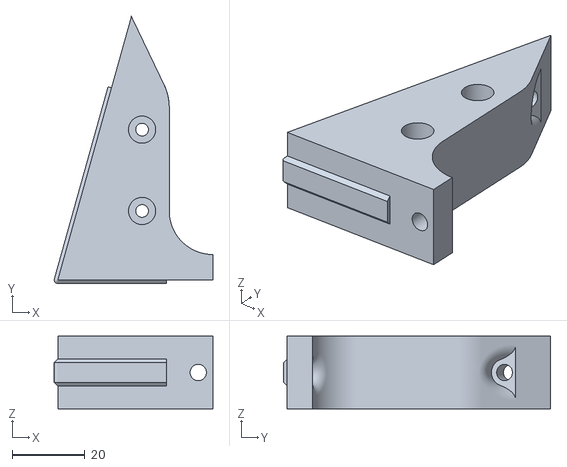
[picture p52: CAD file, 2023-11-13]
OpenAstroTracker/Pieces STL/files/b1_connector_right.STL
43.7 x 73.6 x 20.0
