Phil-dav/OpenAstroTracker/OpenAstroTracker/Pieces STL/files/06a_splitring_part1_v4.STL

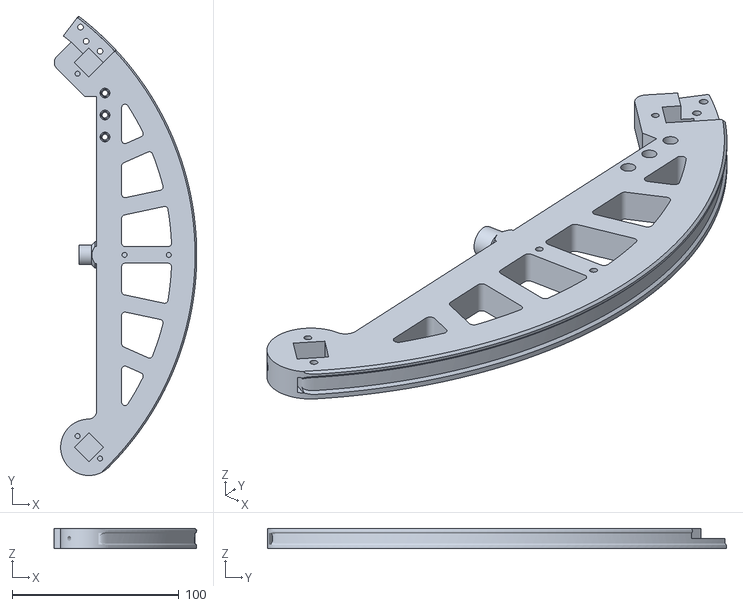
[picture p53: CAD file, 2023-11-13]
OpenAstroTracker/Pieces STL/files/06a_splitring_part1_v4.STL
85.4 x 275.1 x 12.0
