Phil-dav/OpenAstroTracker/OpenAstroTracker/Pieces STL/Pièces à réalisées/03_polemount_6801_v3_TI.STL

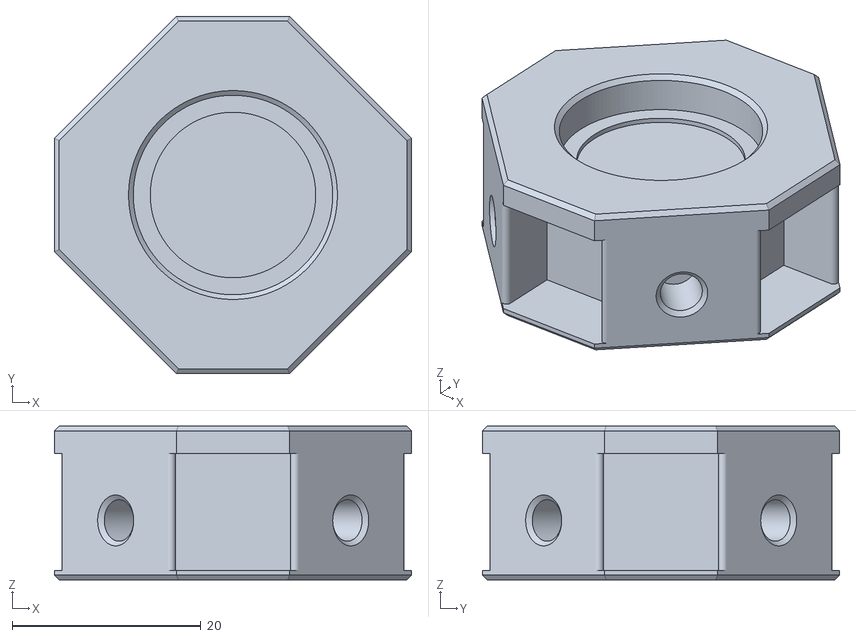
[picture p54: CAD file, 2023-11-13]
OpenAstroTracker/Pieces STL/Pièces à réalisées/03_polemount_6801_v3_TI.STL
37.9 x 37.9 x 16.3
