Phil-dav/OpenAstroTracker/OpenAstroTracker/Pieces STL/files/14_RAmotor_mount_NEMA_down_v4.STL

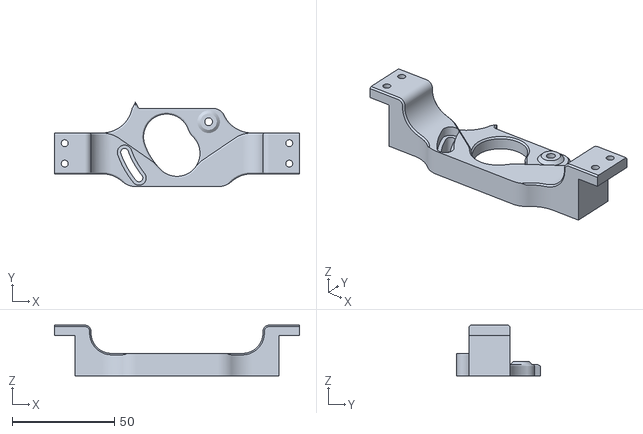
[picture p55: CAD file, 2023-11-13]
OpenAstroTracker/Pieces STL/files/14_RAmotor_mount_NEMA_down_v4.STL
120.0 x 41.3 x 24.8
