Phil-dav/OpenAstroTracker/OpenAstroTracker/Pieces STL/Pièces à réalisées/05.1_pole_v4_TI.STL

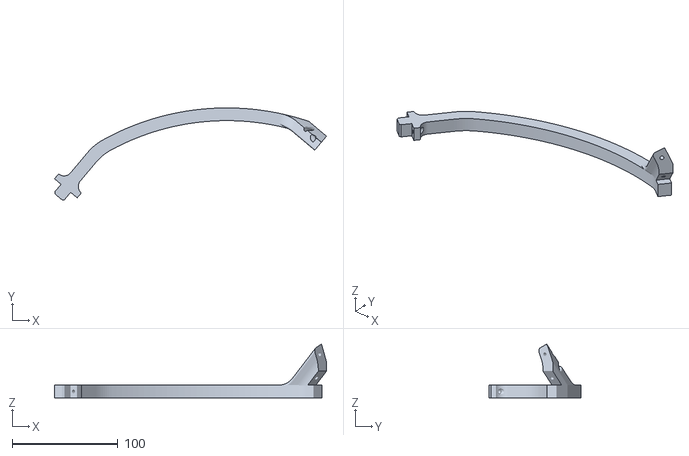
[picture p56: CAD file, 2023-11-13]
OpenAstroTracker/Pieces STL/Pièces à réalisées/05.1_pole_v4_TI.STL
256.6 x 86.9 x 50.7
