Phil-dav/OpenAstroTracker/OpenAstroTracker/Pieces STL/files/c4_buttons.STL

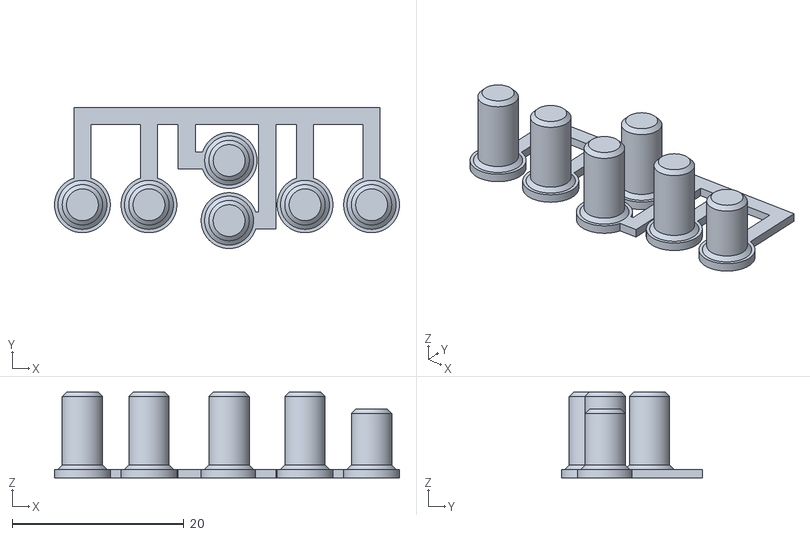
[picture p57: CAD file, 2023-11-13]
OpenAstroTracker/Pieces STL/files/c4_buttons.STL
40.2 x 16.4 x 10.0
