Phil-dav/OpenAstroTracker/OpenAstroTracker/Pieces STL/files/16_NEMA_electronicsbox.STL

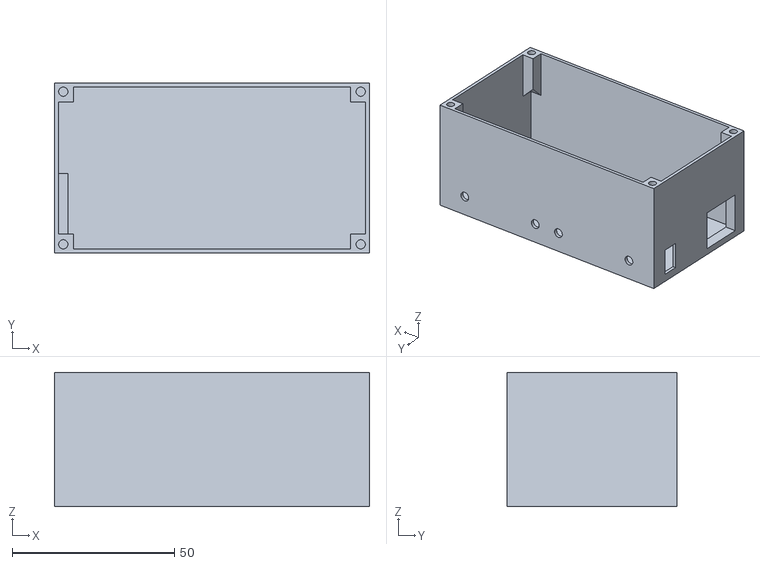
[picture p58: CAD file, 2023-11-13]
OpenAstroTracker/Pieces STL/files/16_NEMA_electronicsbox.STL
97.0 x 52.4 x 41.3
