Phil-dav/OpenAstroTracker/OpenAstroTracker/Pieces STL/Pièces à réalisées/u1_Lholder_right_back.STL

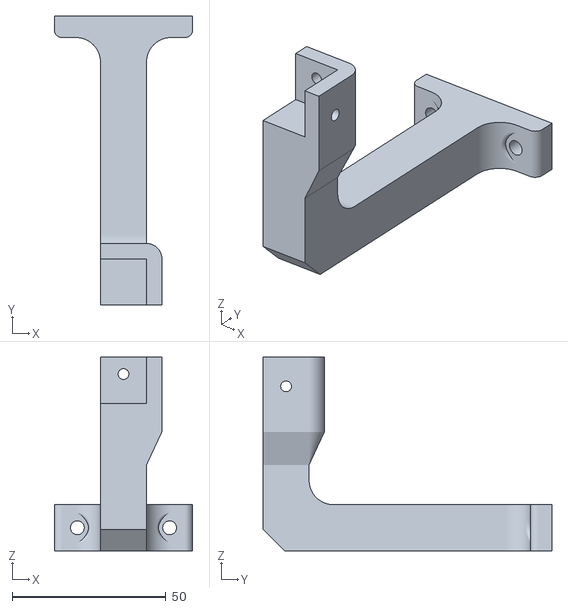
[picture p59: CAD file, 2023-11-13]
OpenAstroTracker/Pieces STL/Pièces à réalisées/u1_Lholder_right_back.STL
45.0 x 94.0 x 63.0
