Phil-dav/OpenAstroTracker/OpenAstroTracker/Pieces STL/files/11_DEC_motor_mount_v7.STL

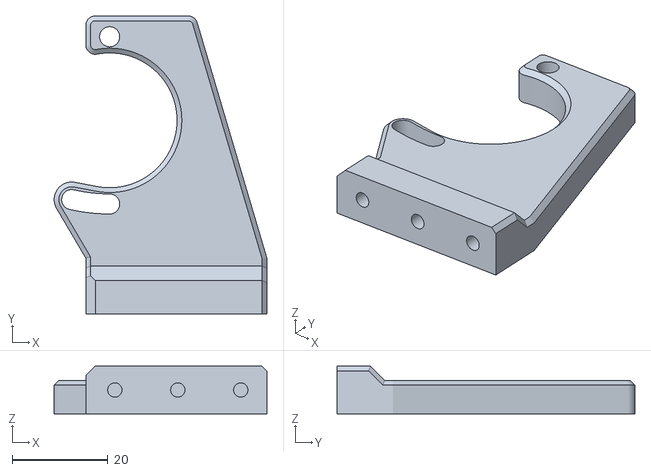
[picture p60: CAD file, 2023-11-13]
OpenAstroTracker/Pieces STL/files/11_DEC_motor_mount_v7.STL
44.5 x 62.4 x 10.0
