Phil-dav/OpenAstroTracker/OpenAstroTracker/Pieces STL/files/01b_Baseplate_part2_universal_200x200_v2.STL

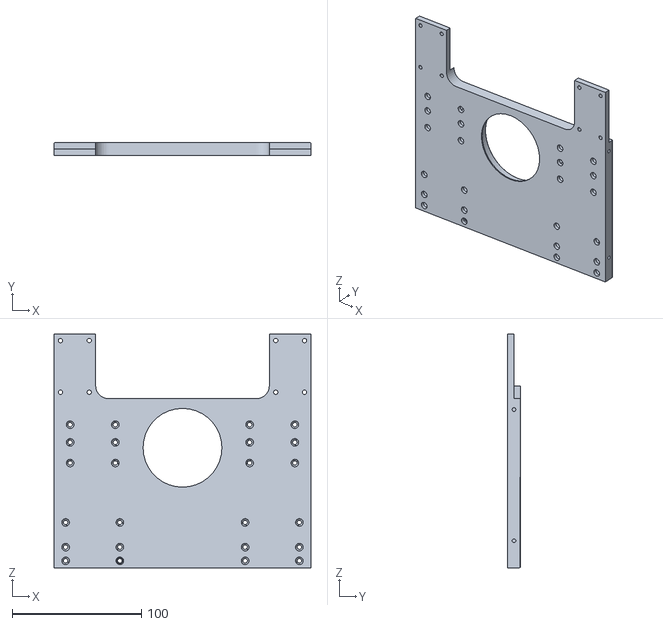
[picture p61: CAD file, 2023-11-13]
OpenAstroTracker/Pieces STL/files/01b_Baseplate_part2_universal_200x200_v2.STL
199.0 x 10.0 x 181.0
