Phil-dav/OpenAstroTracker/OpenAstroTracker/Pieces STL/Pièces à réalisées/b2_level holder_31mm.STL

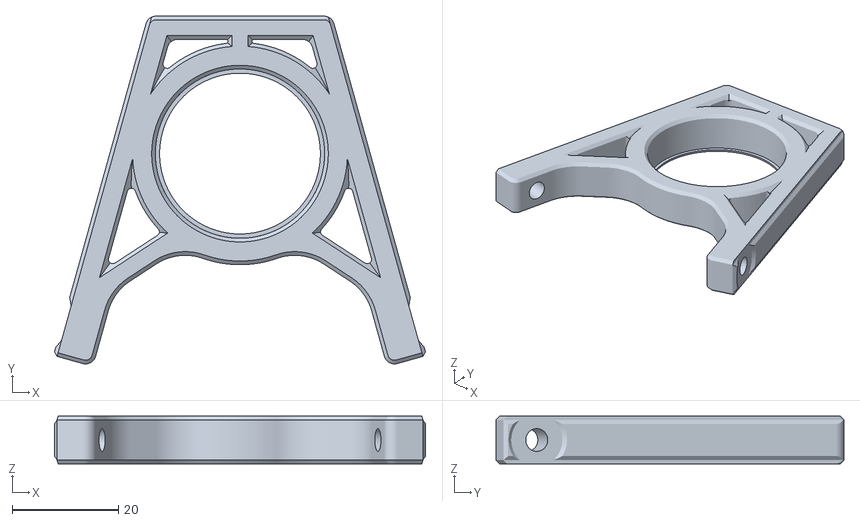
[picture p62: CAD file, 2023-11-13]
OpenAstroTracker/Pieces STL/Pièces à réalisées/b2_level holder_31mm.STL
69.9 x 65.6 x 9.00
