Phil-dav/OpenAstroTracker/OpenAstroTracker/Pieces STL/files/c2_front.STL

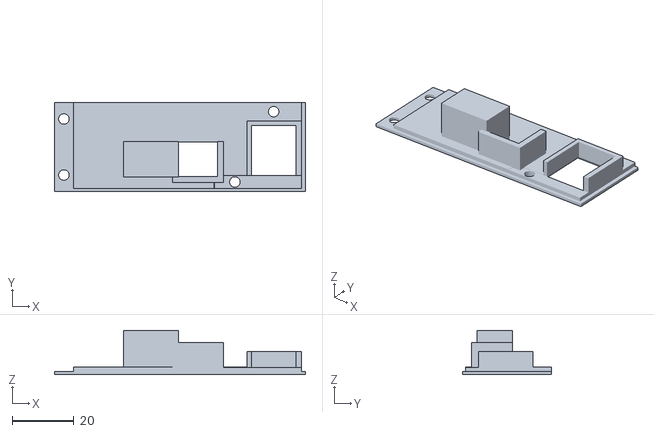
[picture p63: CAD file, 2023-11-13]
OpenAstroTracker/Pieces STL/files/c2_front.STL
81.4 x 29.0 x 14.3
