Phil-dav/OpenAstroTracker/OpenAstroTracker/Pieces STL/Pièces à réalisées/M14_mount_right_2020base.STL

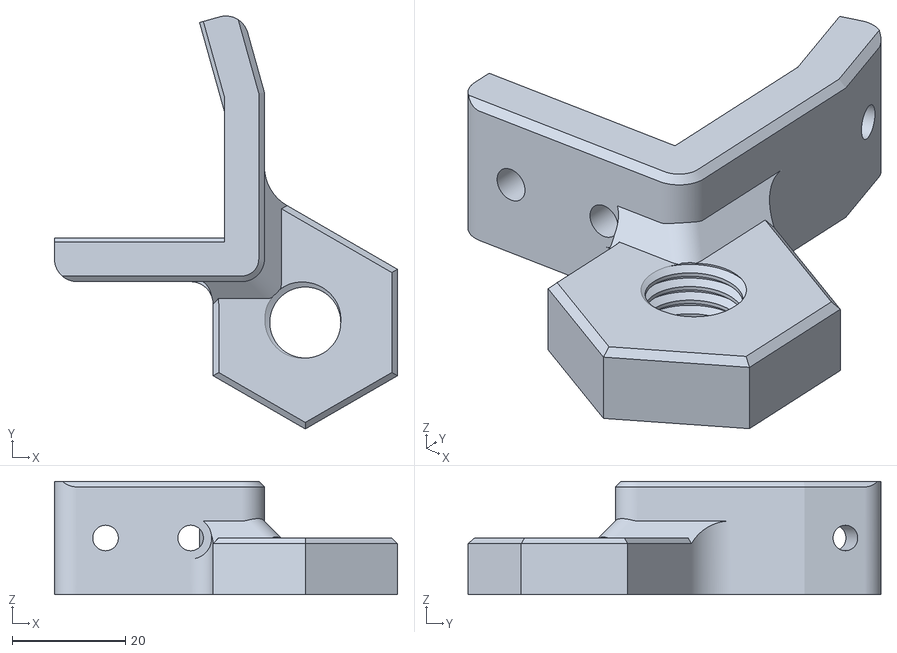
[picture p64: CAD file, 2023-11-13]
OpenAstroTracker/Pieces STL/Pièces à réalisées/M14_mount_right_2020base.STL
60.4 x 72.8 x 20.0
