Phil-dav/OpenAstroTracker/OpenAstroTracker/Pieces STL/files/14_RAmotor_mount_low_200x200_v4.STL

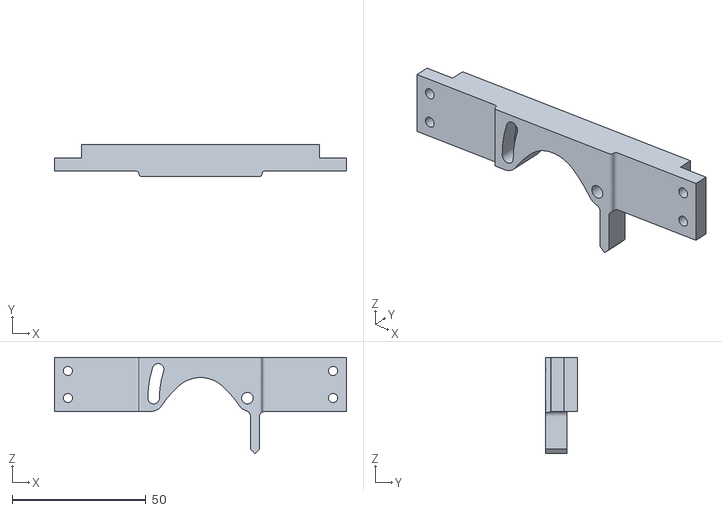
[picture p65: CAD file, 2023-11-13]
OpenAstroTracker/Pieces STL/files/14_RAmotor_mount_low_200x200_v4.STL
109.0 x 12.0 x 35.9
