Phil-dav/OpenAstroTracker/OpenAstroTracker/Pieces STL/Pièces à réalisées/u1_Lholder_left_back.STL

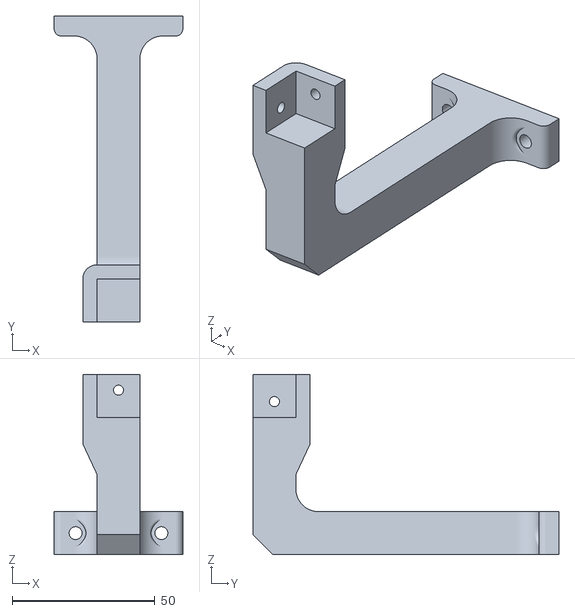
[picture p66: CAD file, 2023-11-13]
OpenAstroTracker/Pieces STL/Pièces à réalisées/u1_Lholder_left_back.STL
45.0 x 107.0 x 63.0
