Phil-dav/OpenAstroTracker/OpenAstroTracker/Pieces STL/files/14_RAmotor_mount_v5.STL

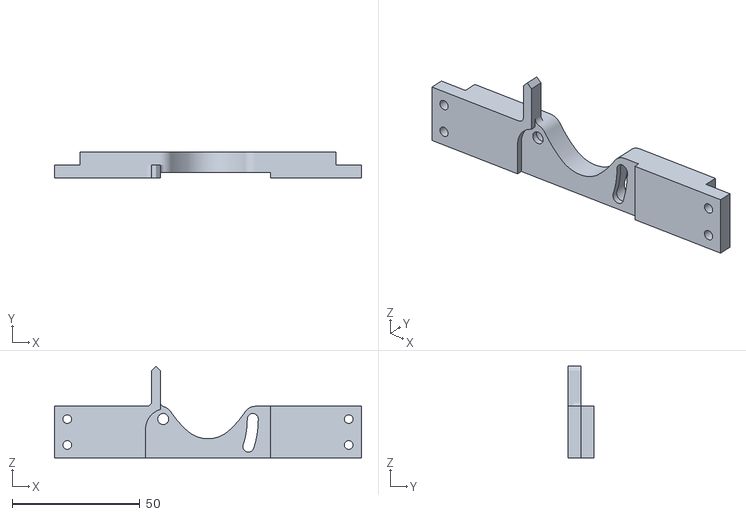
[picture p67: CAD file, 2023-11-13]
OpenAstroTracker/Pieces STL/files/14_RAmotor_mount_v5.STL
120.0 x 10.0 x 35.9
