Phil-dav/OpenAstroTracker/OpenAstroTracker/Pieces STL/files/11_DEC_motor_mount_v9_NEMA.STL

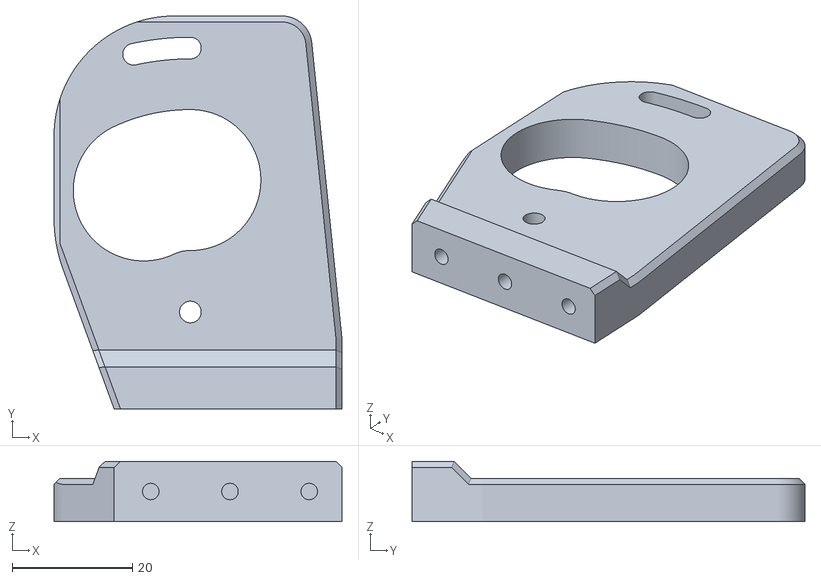
[picture p68: CAD file, 2023-11-13]
OpenAstroTracker/Pieces STL/files/11_DEC_motor_mount_v9_NEMA.STL
47.9 x 65.4 x 10.0
