Phil-dav/OpenAstroTracker/OpenAstroTracker/Pieces STL/files/15_Pulley_GT2.STL

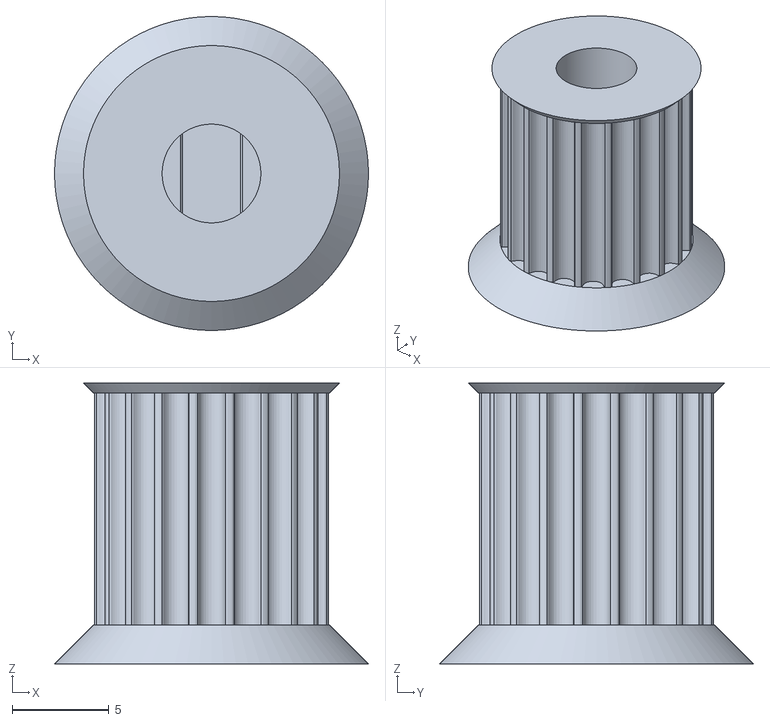
[picture p69: CAD file, 2023-11-13]
OpenAstroTracker/Pieces STL/files/15_Pulley_GT2.STL
16.2 x 16.2 x 14.5
