Phil-dav/OpenAstroTracker/OpenAstroTracker/Pieces STL/Pièces à réalisées/05.2_stabilizer.STL

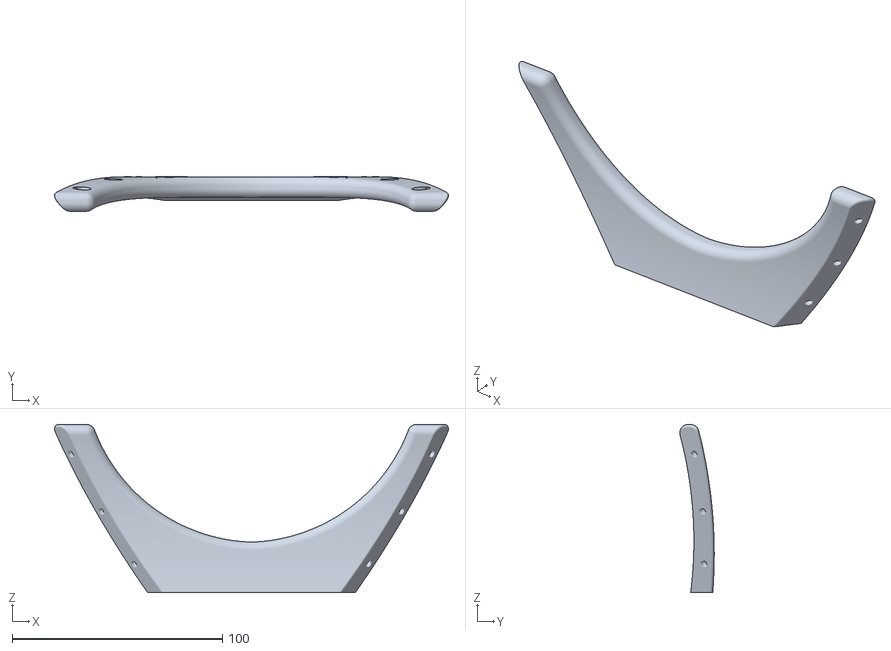
[picture p70: CAD file, 2023-11-13]
OpenAstroTracker/Pieces STL/Pièces à réalisées/05.2_stabilizer.STL
187.6 x 16.4 x 80.0
