Phil-dav/OpenAstroTracker/OpenAstroTracker/Pieces STL/files/b3_2020 adapter.STL

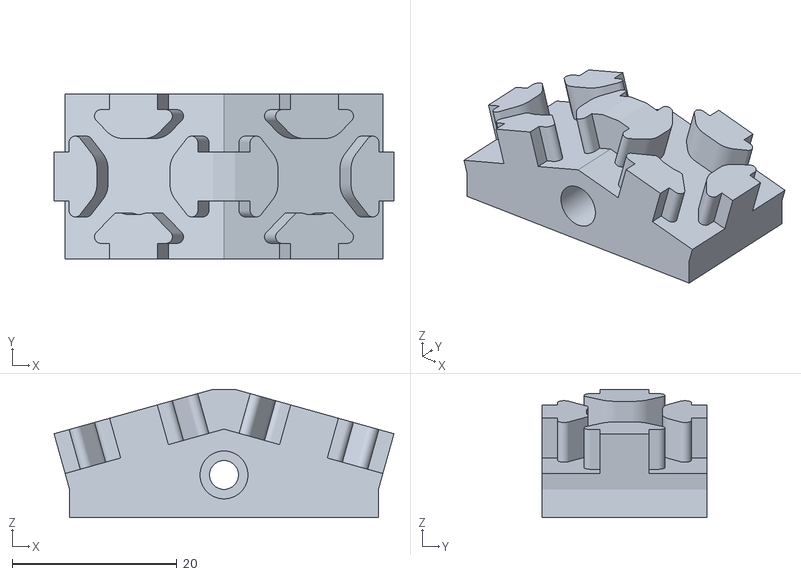
[picture p71: CAD file, 2023-11-13]
OpenAstroTracker/Pieces STL/files/b3_2020 adapter.STL
41.2 x 20.0 x 15.5
