Phil-dav/OpenAstroTracker/OpenAstroTracker/Pieces STL/files/16_electronicsbox_top_2020base.STL

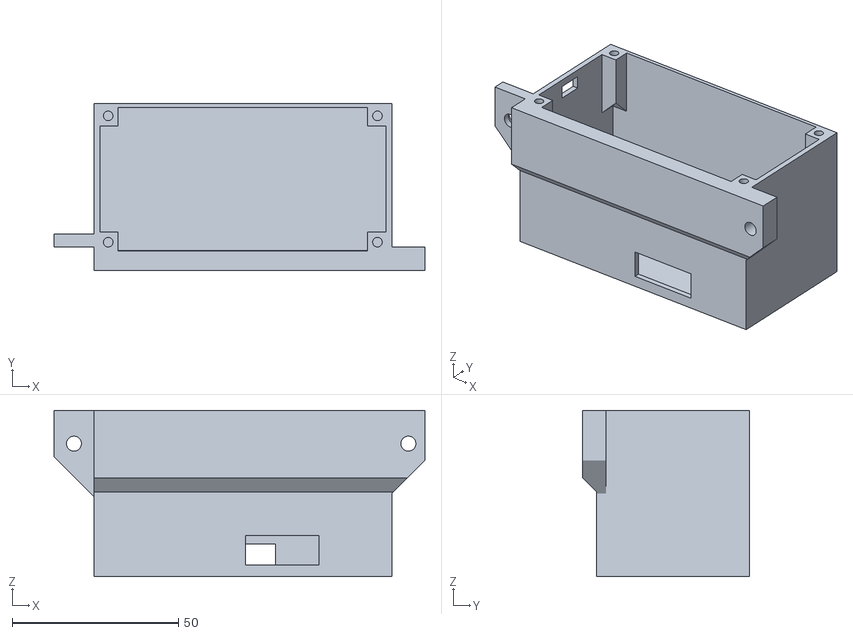
[picture p72: CAD file, 2023-11-13]
OpenAstroTracker/Pieces STL/files/16_electronicsbox_top_2020base.STL
111.6 x 50.2 x 50.0
