Phil-dav/OpenAstroTracker/OpenAstroTracker/Pieces STL/Pièces à réalisées/u4_holder.STL

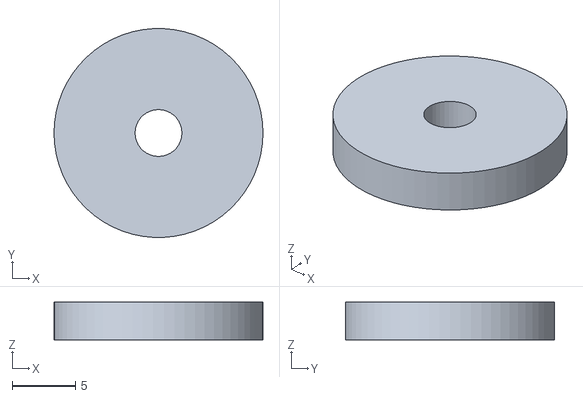
[picture p73: CAD file, 2023-11-13]
OpenAstroTracker/Pieces STL/Pièces à réalisées/u4_holder.STL
16.5 x 16.5 x 3.00
