Phil-dav/OpenAstroTracker/OpenAstroTracker/Pieces STL/Pièces à réalisées/u2_bearing_holder_TI.STL

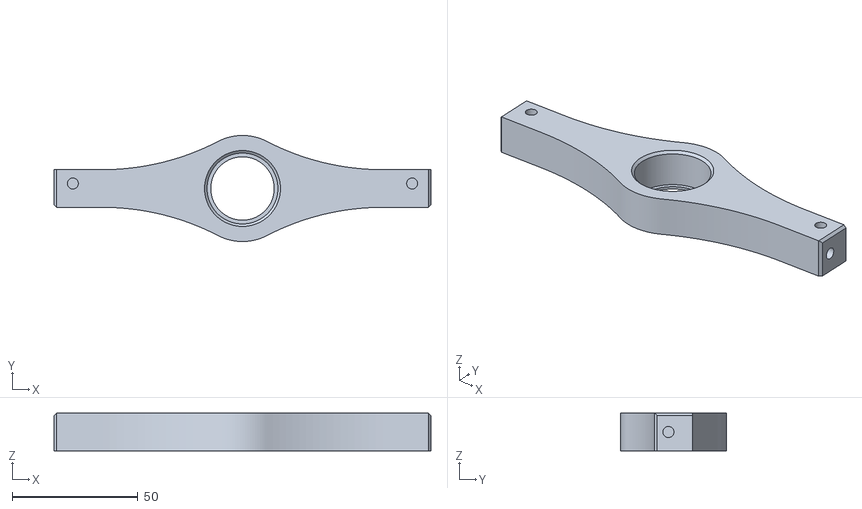
[picture p74: CAD file, 2023-11-13]
OpenAstroTracker/Pieces STL/Pièces à réalisées/u2_bearing_holder_TI.STL
150.0 x 42.2 x 15.0
