Phil-dav/OpenAstroTracker/OpenAstroTracker/Pieces STL/files/14_RAmotor_mount_low_v4.STL

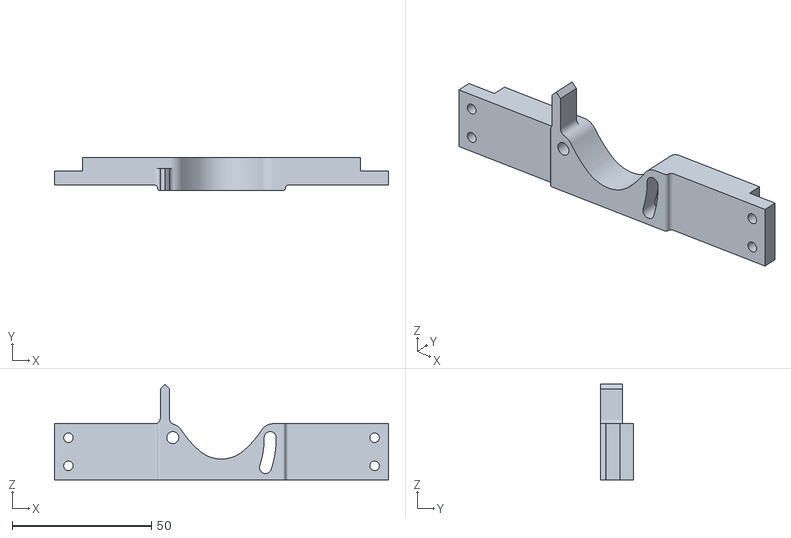
[picture p75: CAD file, 2023-11-13]
OpenAstroTracker/Pieces STL/files/14_RAmotor_mount_low_v4.STL
120.0 x 12.0 x 34.4
