Phil-dav/OpenAstroTracker/OpenAstroTracker/Pieces STL/files/u5_M14_counterweight attachment.STL

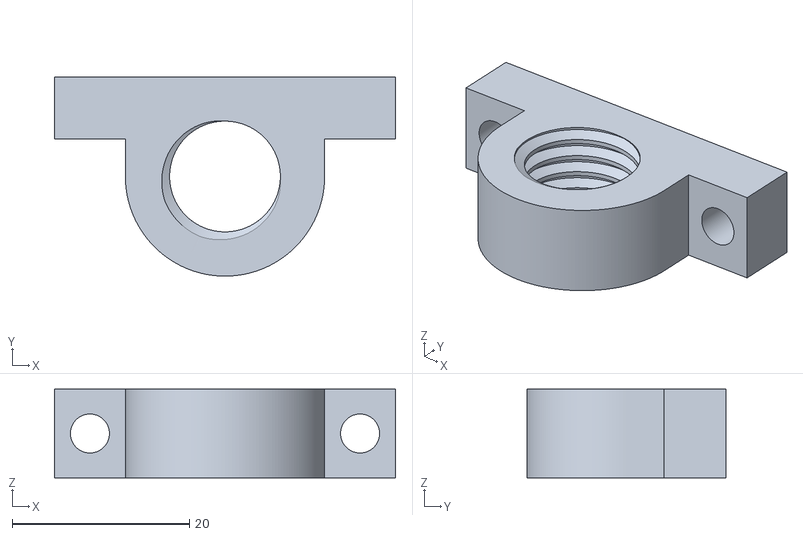
[picture p76: CAD file, 2023-11-13]
OpenAstroTracker/Pieces STL/files/u5_M14_counterweight attachment.STL
38.5 x 22.5 x 10.00
