Phil-dav/OpenAstroTracker/OpenAstroTracker/Pieces STL/files/16_electronicsbox_top_2020base_cat6.STL

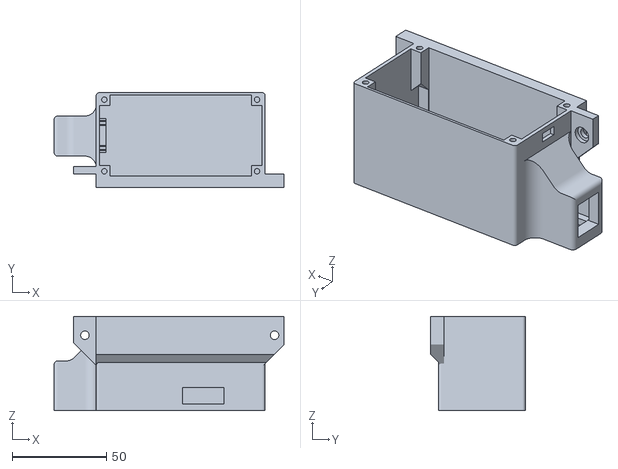
[picture p77: CAD file, 2023-11-13]
OpenAstroTracker/Pieces STL/files/16_electronicsbox_top_2020base_cat6.STL
122.0 x 50.2 x 50.0
