Phil-dav/OpenAstroTracker/OpenAstroTracker/Pieces STL/files/c3_top.STL

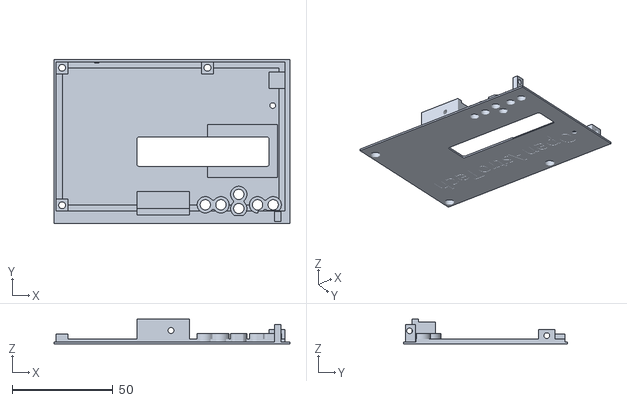
[picture p78: CAD file, 2023-11-13]
OpenAstroTracker/Pieces STL/files/c3_top.STL
117.0 x 81.4 x 12.2
