Phil-dav/OpenAstroTracker/(list of files, cad)

Other CAD files:
OpenAstroTracker/Pieces STL/files/30deg/04_rollmount left_30°_v6_2020base.STL
OpenAstroTracker/Pieces STL/files/40deg/04_rollmount right_40°_v6_2020base.STL
OpenAstroTracker/Pieces STL/files/20deg/04_rollmount right_20°_v5_2020base.STL
OpenAstroTracker/Pieces STL/Pièces à réalisées/04_rollmount right_40°_v6_2020base.STL
OpenAstroTracker/Pieces STL/Pièces à réalisées/06b_splitring_part2_v4_TI.STL
OpenAstroTracker/Pieces STL/Pièces à réalisées/06a_splitring_part1_v4_TI.STL
OpenAstroTracker/Pieces STL/Pièces à réalisées/u1_Lholder_right_front.STL
OpenAstroTracker/Pieces STL/files/11_DEC_motor_mount_v8_low.STL
OpenAstroTracker/Pieces STL/Pièces à réalisées/M14_mount_left_2020base.STL
OpenAstroTracker/Pieces STL/Pièces à réalisées/06c_splitring_part3_v4_TI.STL
OpenAstroTracker/Pieces STL/files/u1_Lholder_left_front.STL
OpenAstroTracker/Pieces STL/Pièces à réalisées/b1_connector_right.STL
OpenAstroTracker/Pieces STL/files/u1_Lholder_left_back.STL
OpenAstroTracker/Pieces STL/Pièces à réalisées/u1_Lholder_left_front.STL
OpenAstroTracker/Pieces STL/files/06c_splitring_part3_v4.STL
OpenAstroTracker/Pieces STL/Pièces à réalisées/b1_connector_left.STL
OpenAstroTracker/Pieces STL/files/b1_connector_left.STL
OpenAstroTracker/Pieces STL/files/M14_mount_right_2020base.STL
OpenAstroTracker/Pieces STL/files/05_pole_v5.STL
OpenAstroTracker/Pieces STL/files/u2_bearing_holder.STL
OpenAstroTracker/Pieces STL/files/M14_mount_rear_2020base_v2.STL
OpenAstroTracker/Pieces STL/files/M14_mount_left_2020base.STL
