Phil-dav/OpenAstroTracker/(commit log)

2023-11-12 init githup de l'OpenAstro Tracker
2023-11-13 Ajout dossier OpenAstro Tracker
    [00_calibration.STL, 01b_Baseplate_part2_universal_200x200_v2.STL, 02_angle_20deg_2020base.STL, 02_angle_30deg_2020base_v2.STL, 02_angle_40deg_v2_2020base.STL, 02_angle_50deg_v4_2020base.STL, 03_polemount_6801_v3_TI.STL, 04_rollmount left_20°_v5_2020base.STL]
